mseokq23/etri050-6t-sram/docs/img/02/repo_files.png

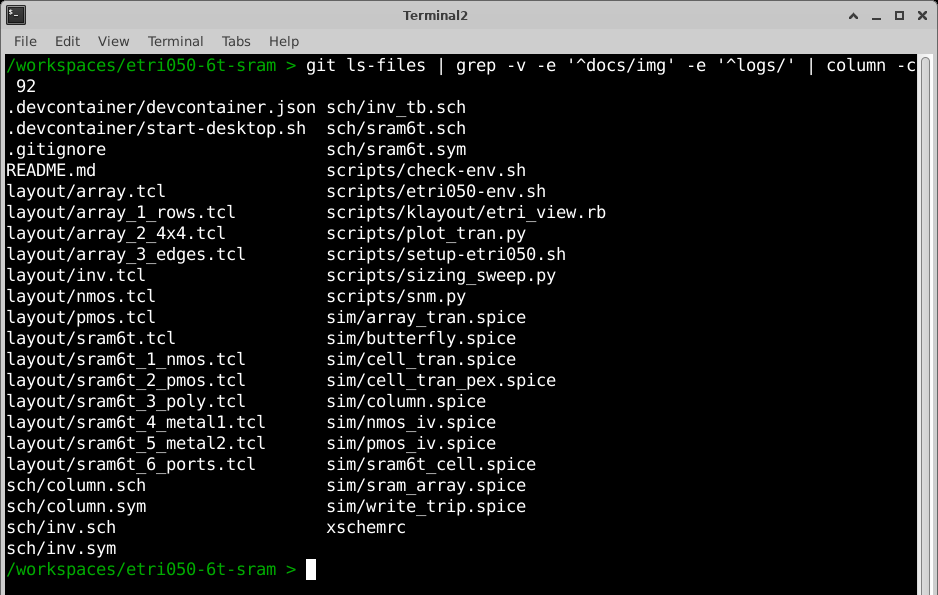
docs/img/02/repo_files.png
