mseokq23/etri050-6t-sram/docs/img/03/desktop.png

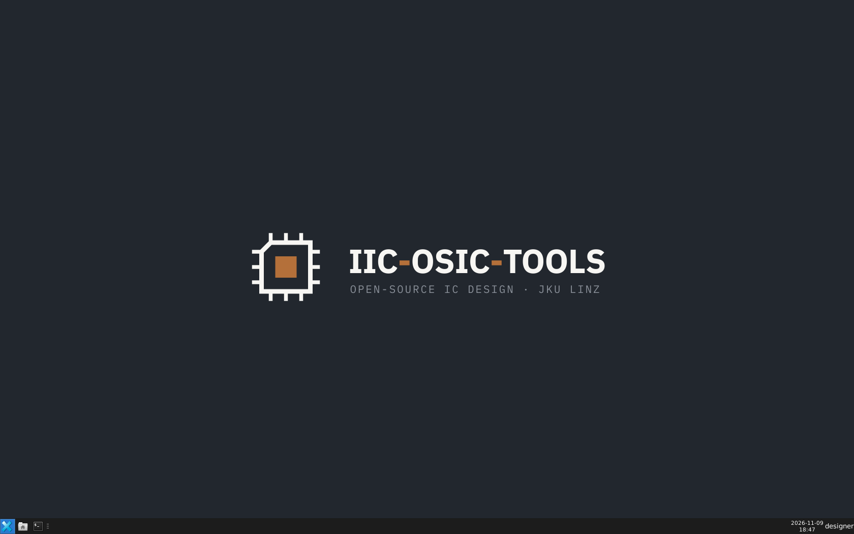
docs/img/03/desktop.png
