mseokq23/etri050-6t-sram/docs/img/03/menu.png

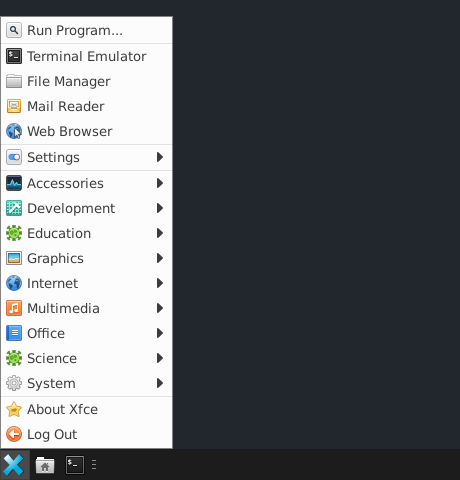
docs/img/03/menu.png
