mseokq23/etri050-6t-sram/docs/img/04/kit_ls.png

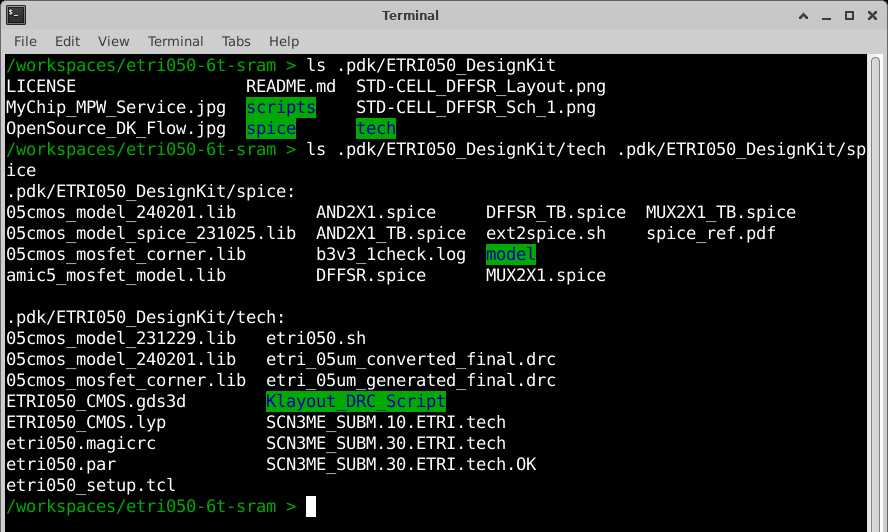
docs/img/04/kit_ls.png
