mseokq23/etri050-6t-sram/docs/img/05/check_env.png

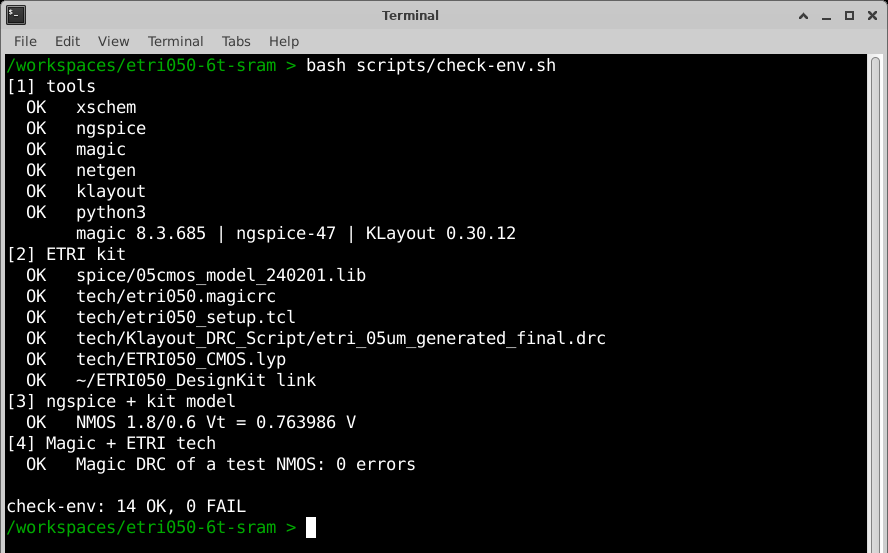
docs/img/05/check_env.png
