mseokq23/etri050-6t-sram/docs/img/05/env_funcs.png

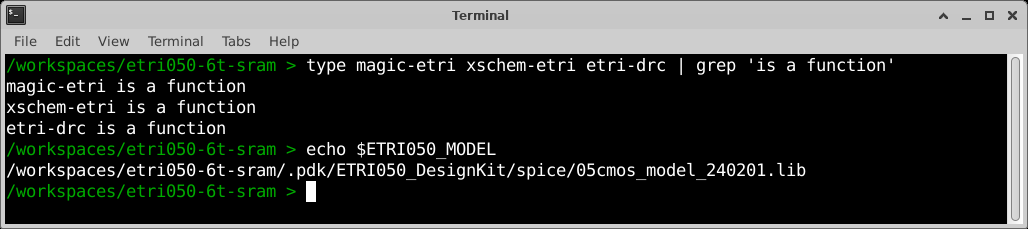
docs/img/05/env_funcs.png
