mseokq23/etri050-6t-sram/docs/img/06/nmos_desktop.png

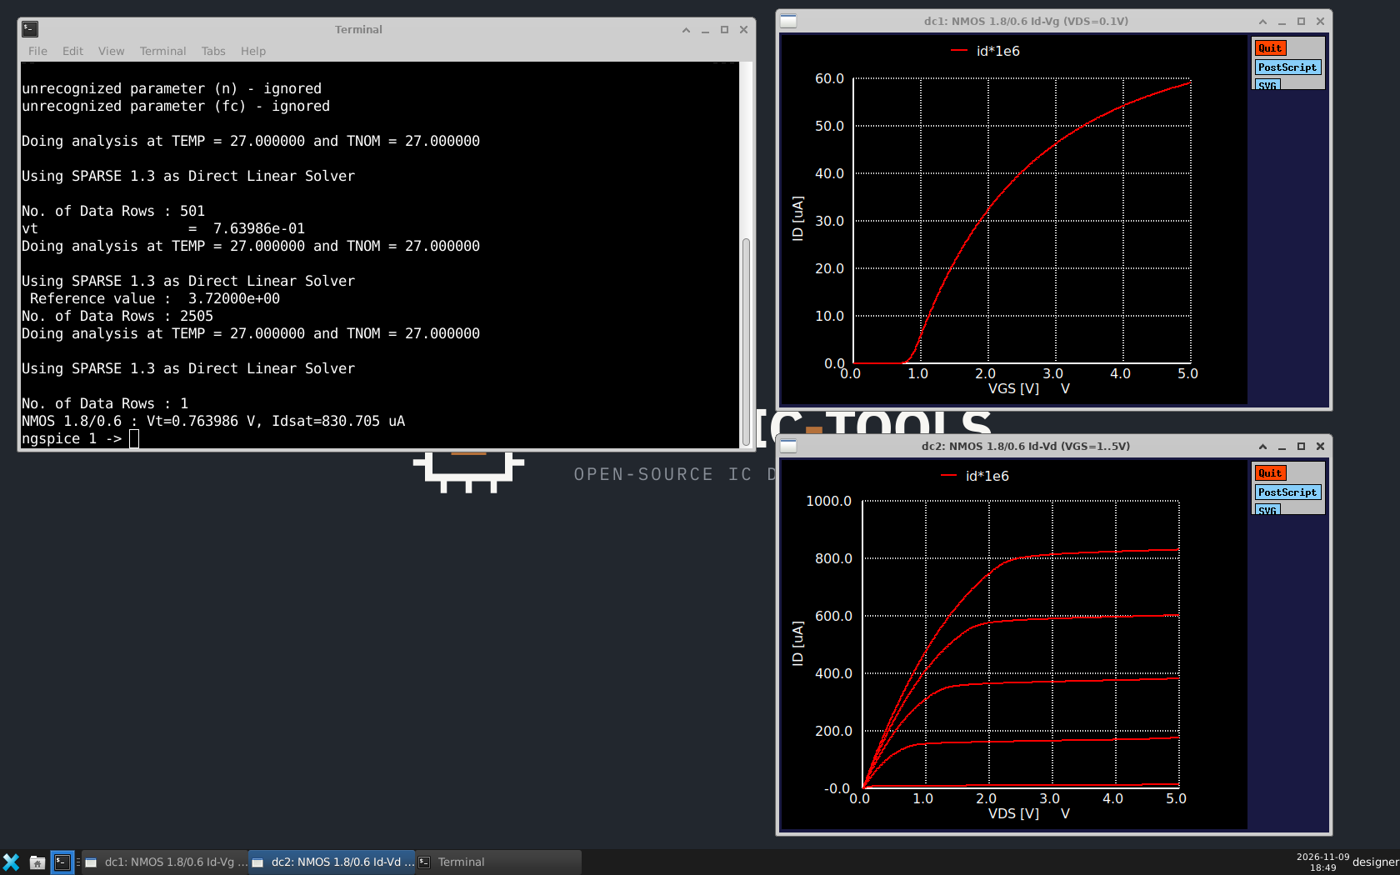
docs/img/06/nmos_desktop.png
