mseokq23/etri050-6t-sram/docs/img/06/nmos_idvg.png

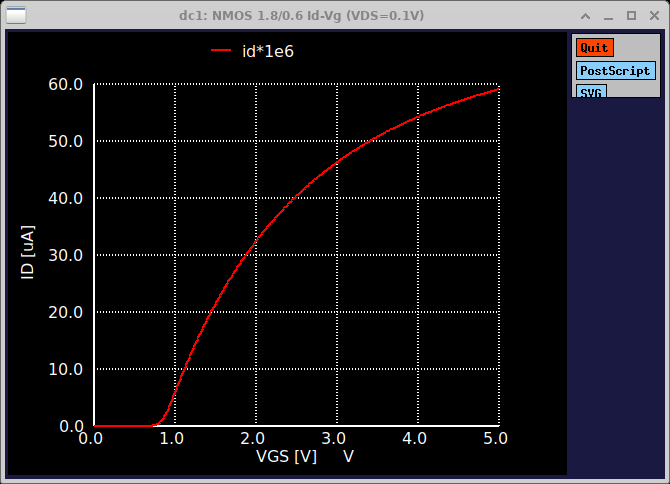
docs/img/06/nmos_idvg.png
