mseokq23/etri050-6t-sram/docs/img/06/nmos_term.png

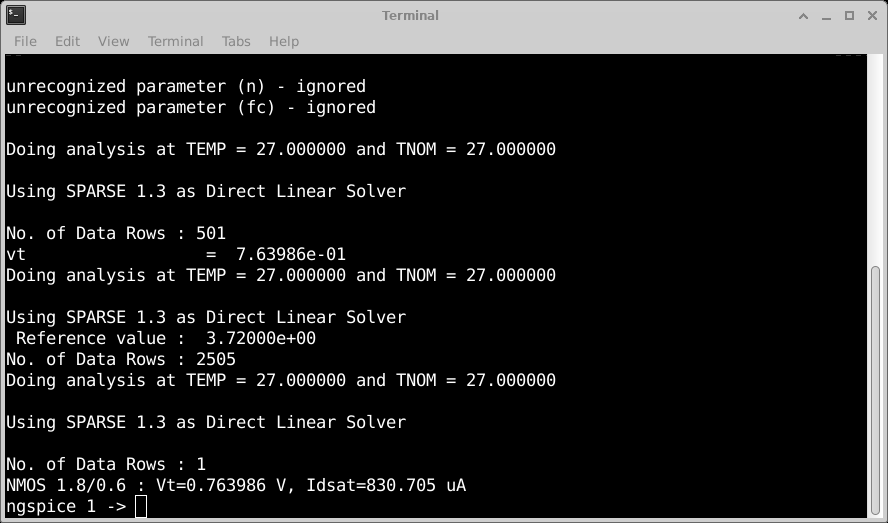
docs/img/06/nmos_term.png
