mseokq23/etri050-6t-sram/docs/img/07/pmos_idvg.png

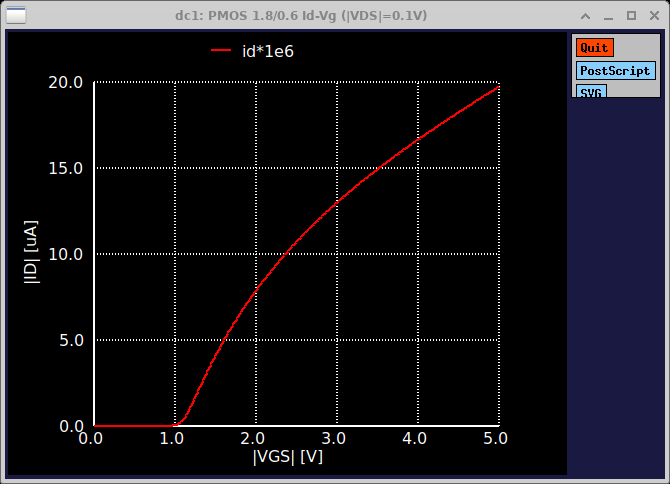
docs/img/07/pmos_idvg.png
