mseokq23/etri050-6t-sram/docs/img/09/insert_dialog_nmos4.png

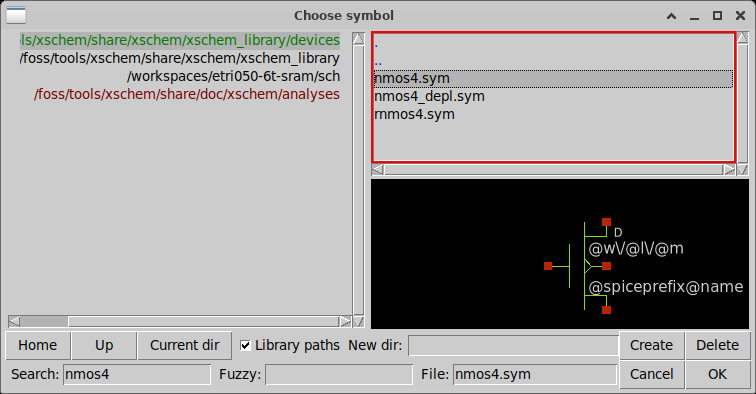
docs/img/09/insert_dialog_nmos4.png
