mseokq23/etri050-6t-sram/docs/img/09/inv_sch.png

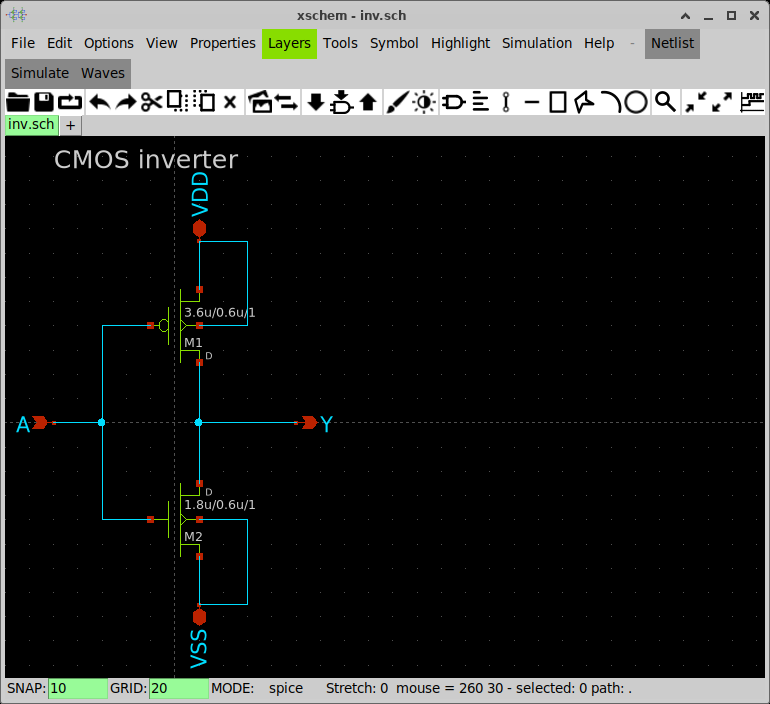
docs/img/09/inv_sch.png
