mseokq23/etri050-6t-sram/docs/img/09/inv_sym.png

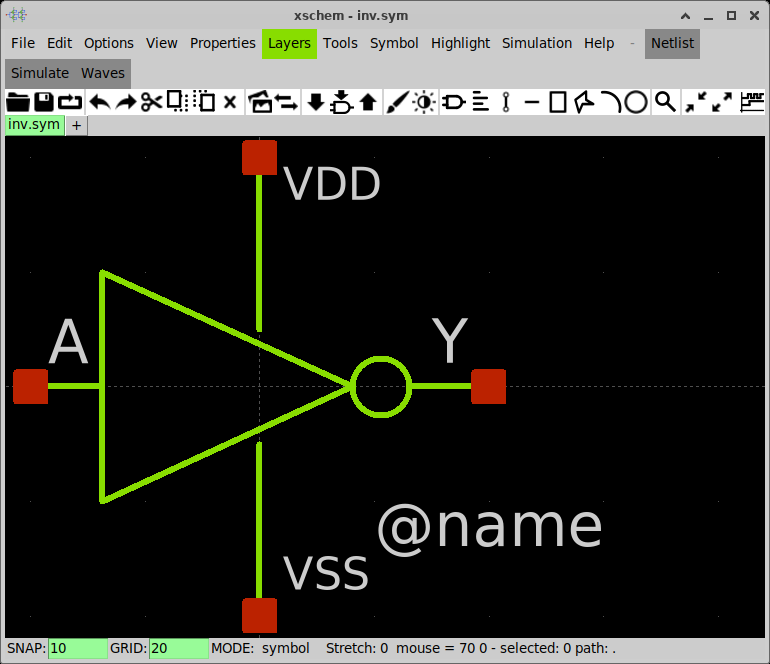
docs/img/09/inv_sym.png
