mseokq23/etri050-6t-sram/docs/img/09/props_desktop.png

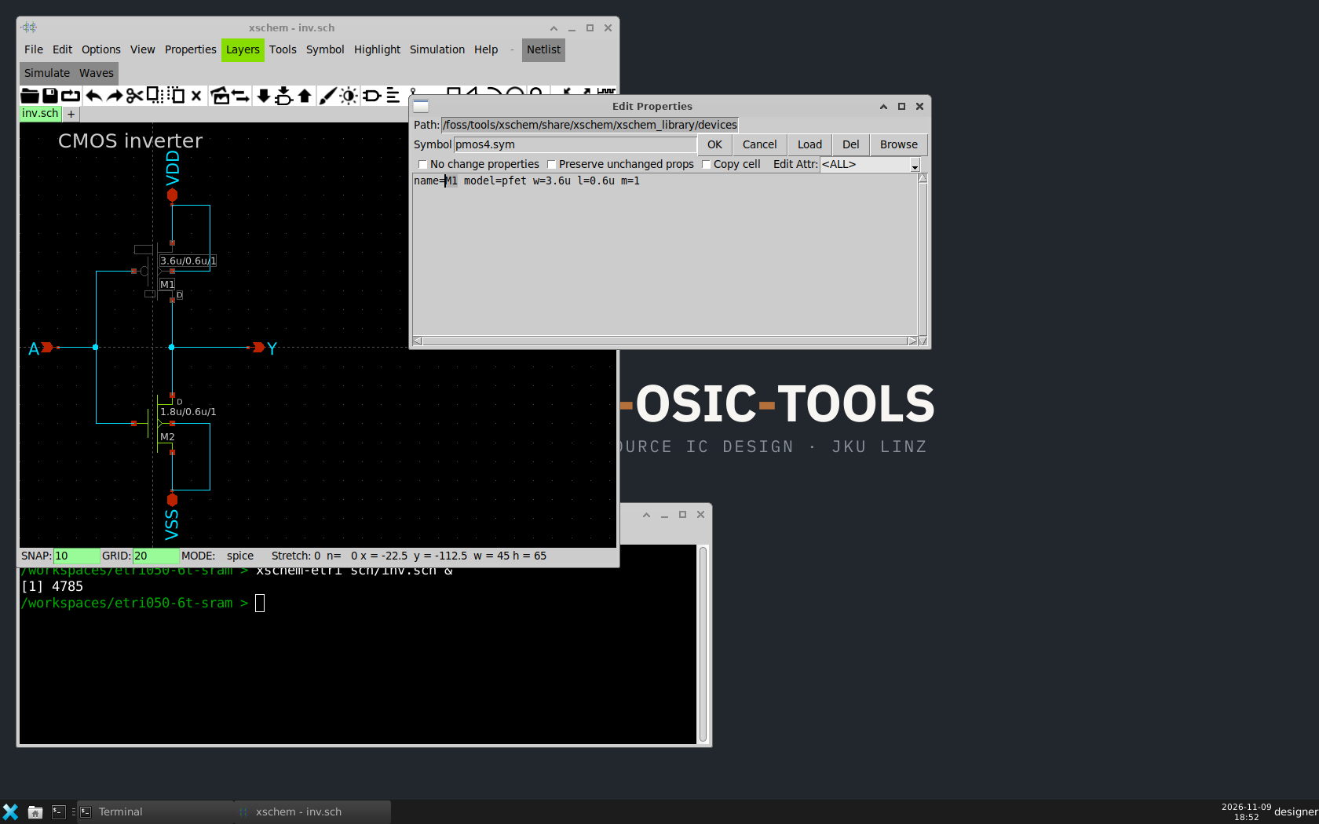
docs/img/09/props_desktop.png
