mseokq23/etri050-6t-sram/docs/img/09/xschem_empty.png

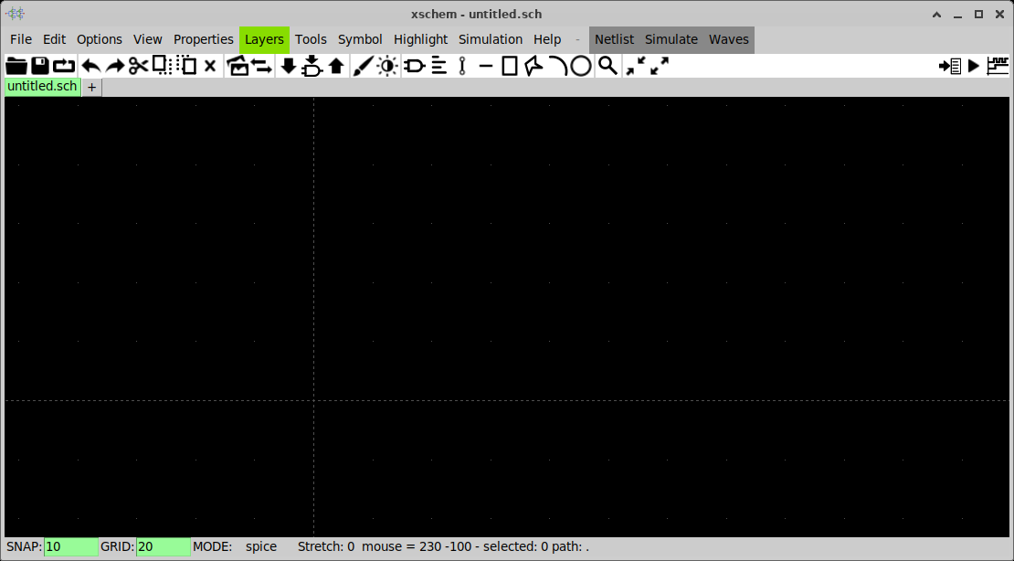
docs/img/09/xschem_empty.png
