mseokq23/etri050-6t-sram/docs/img/09/xschem_empty_desktop.png

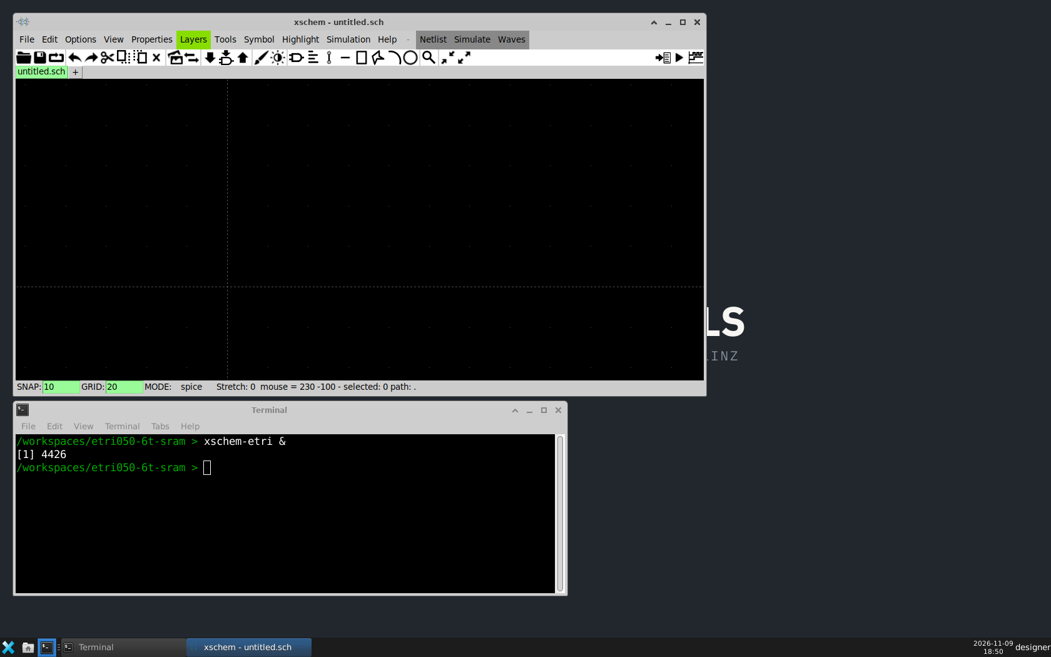
docs/img/09/xschem_empty_desktop.png
