mseokq23/etri050-6t-sram/docs/img/10/inv_tb.png

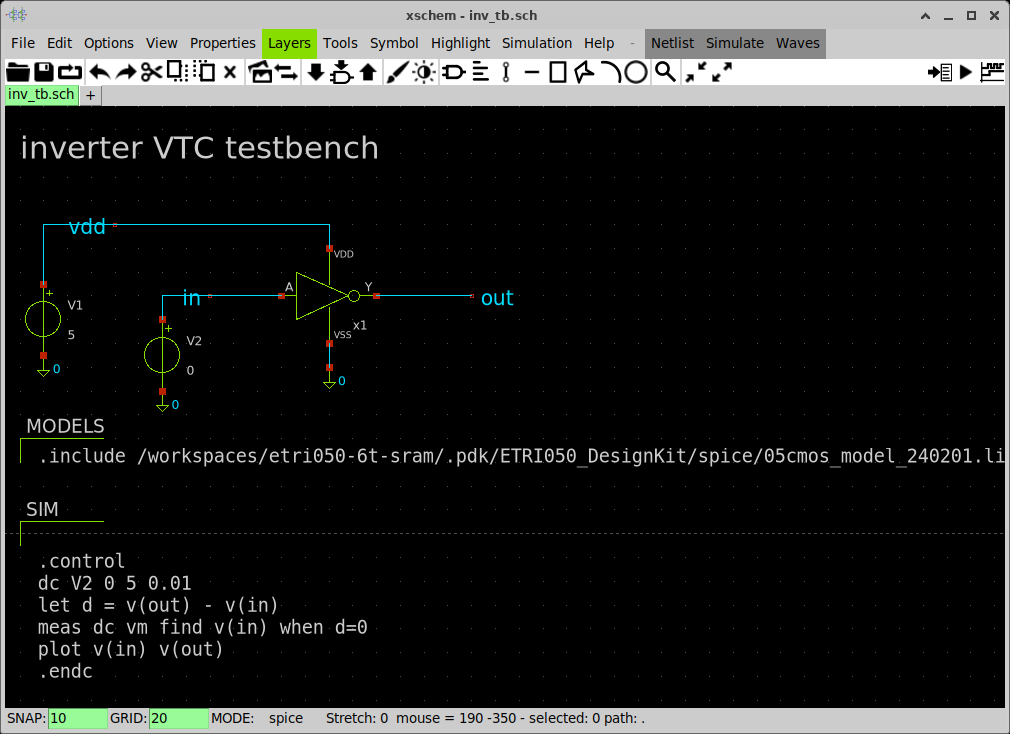
docs/img/10/inv_tb.png
