mseokq23/etri050-6t-sram/docs/img/10/sim_desktop.png

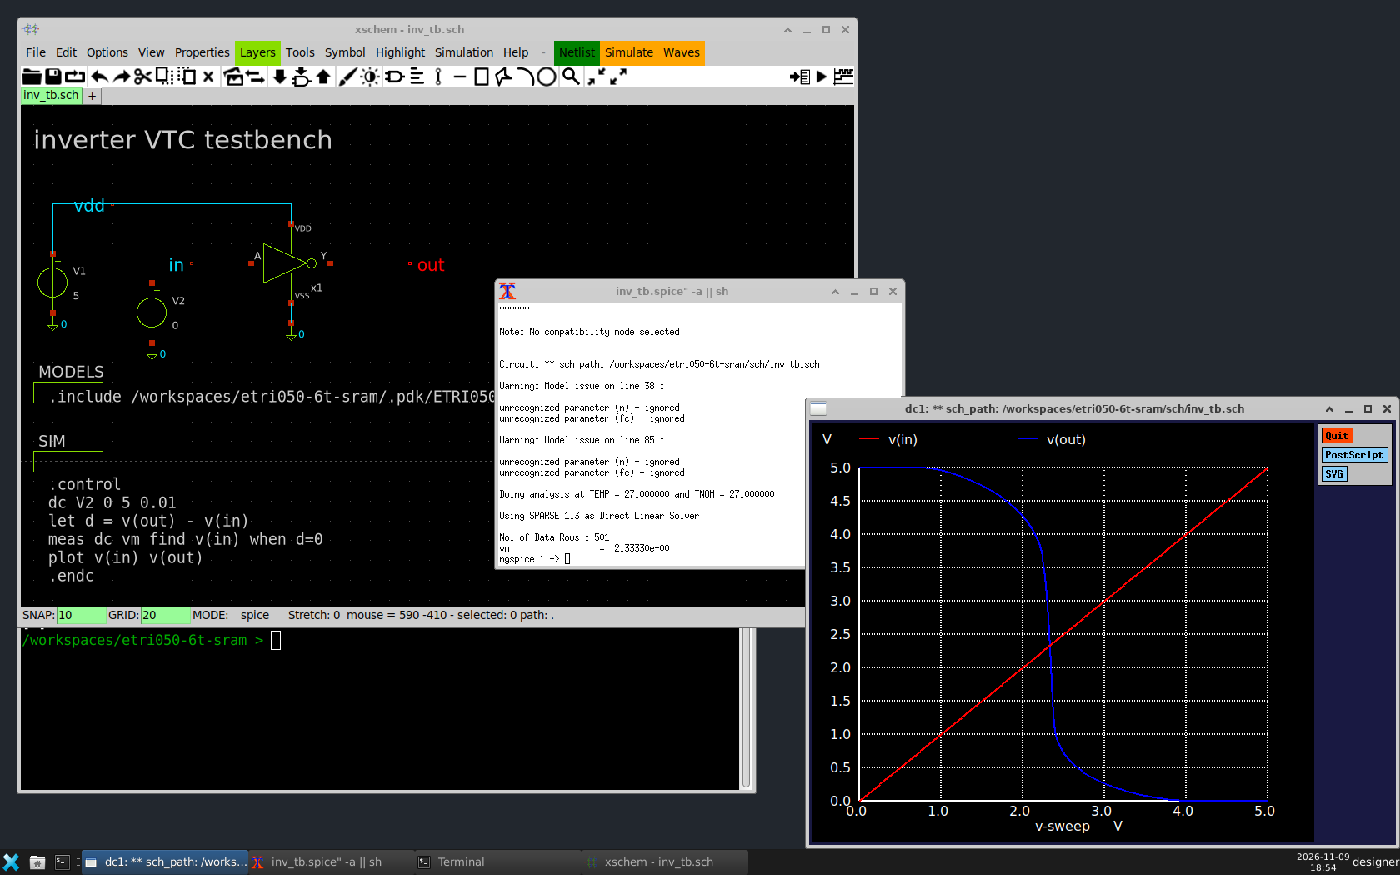
docs/img/10/sim_desktop.png
