mseokq23/etri050-6t-sram/docs/img/10/sim_xterm.png

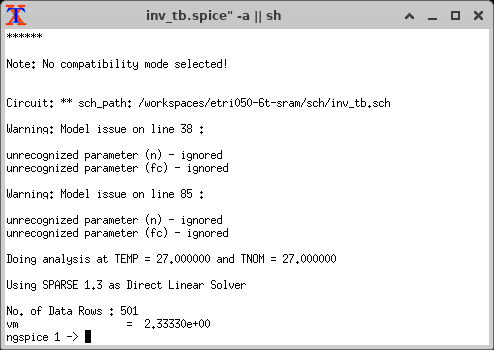
docs/img/10/sim_xterm.png
