mseokq23/etri050-6t-sram/docs/img/10/vtc_plot.png

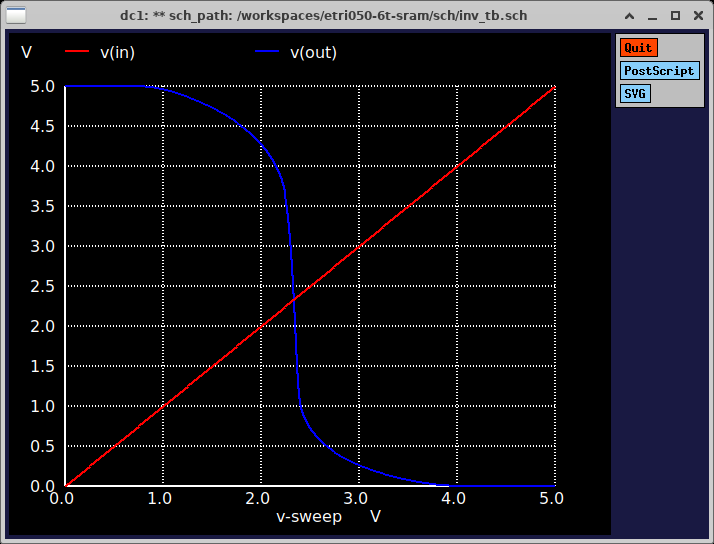
docs/img/10/vtc_plot.png
