mseokq23/etri050-6t-sram/docs/img/11/lvs_netlist.png

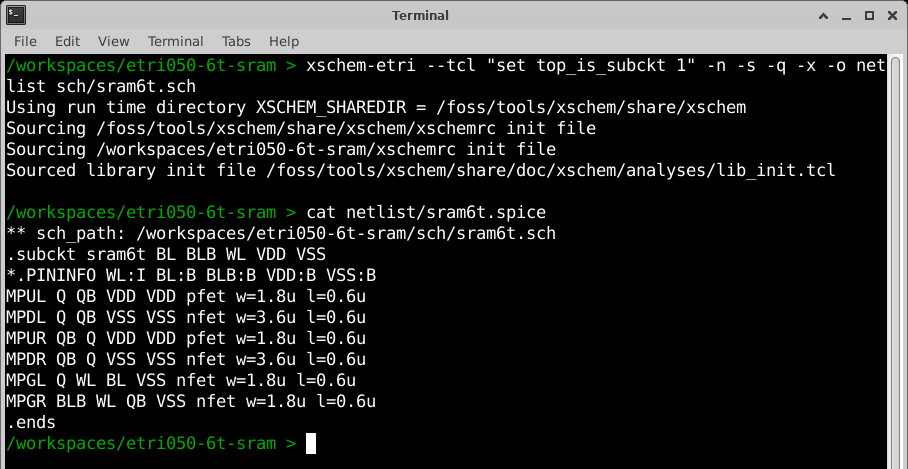
docs/img/11/lvs_netlist.png
