mseokq23/etri050-6t-sram/docs/img/11/sram6t_sch.png

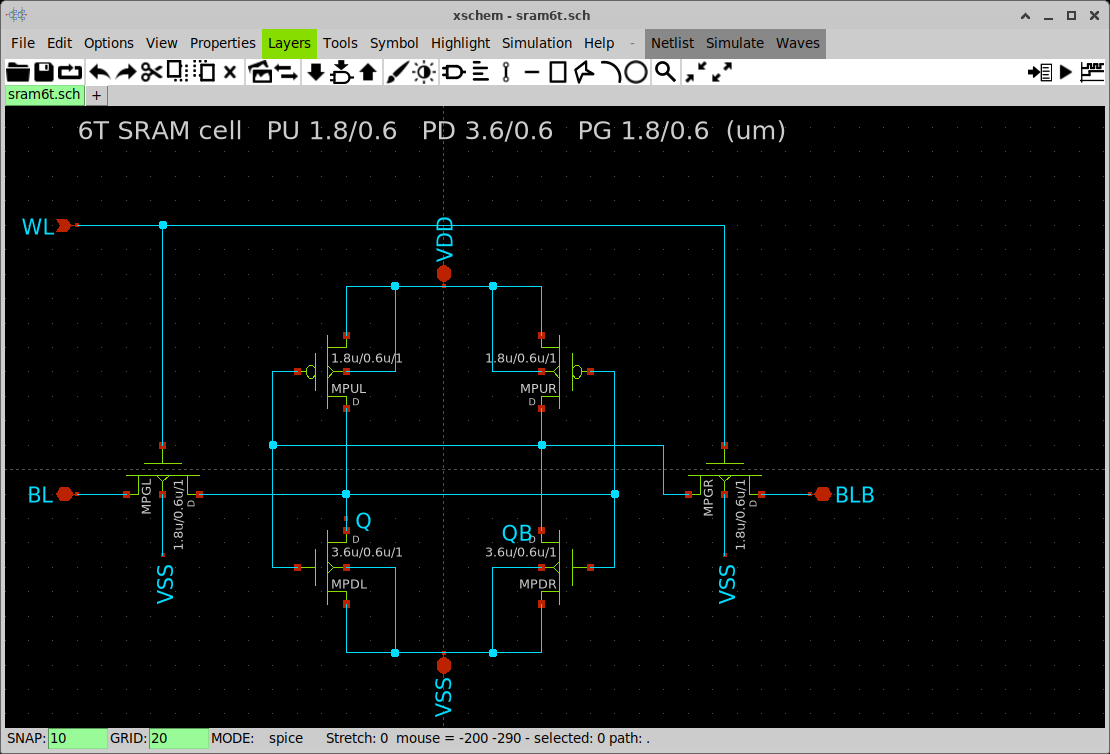
docs/img/11/sram6t_sch.png
