mseokq23/etri050-6t-sram/docs/img/11/sram6t_sym.png

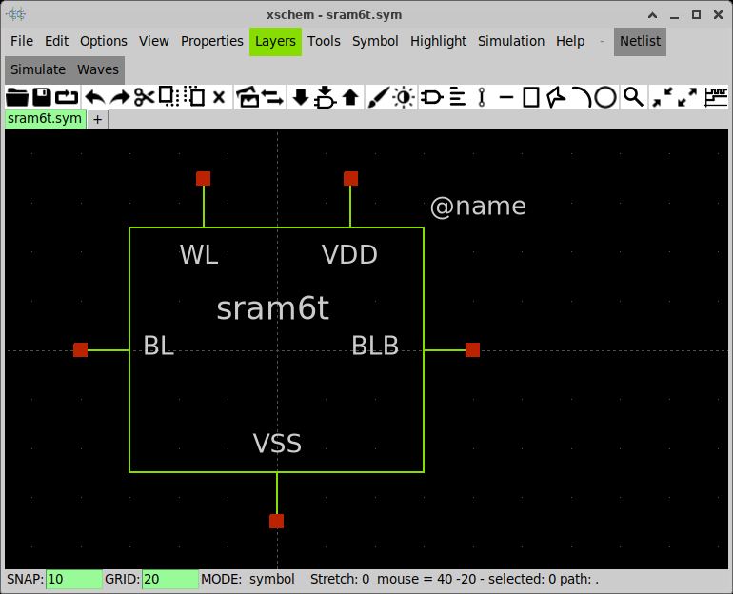
docs/img/11/sram6t_sym.png
