mseokq23/etri050-6t-sram/docs/img/12/butterfly_hold.png

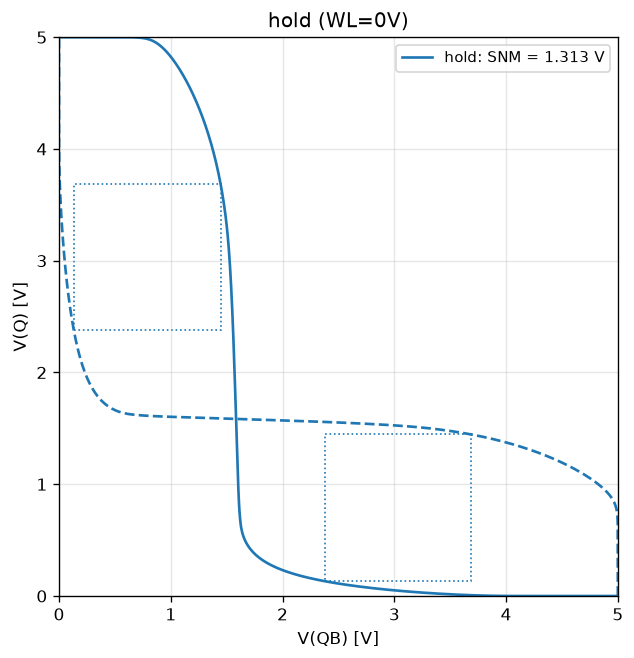
docs/img/12/butterfly_hold.png
