mseokq23/etri050-6t-sram/docs/img/12/snm_hold_term.png

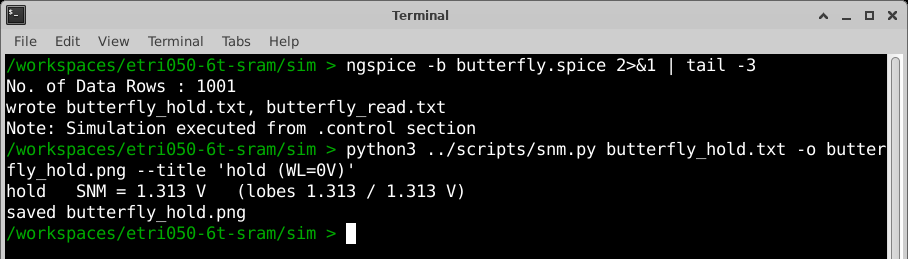
docs/img/12/snm_hold_term.png
