mseokq23/etri050-6t-sram/docs/img/13/butterfly_hold_read.png

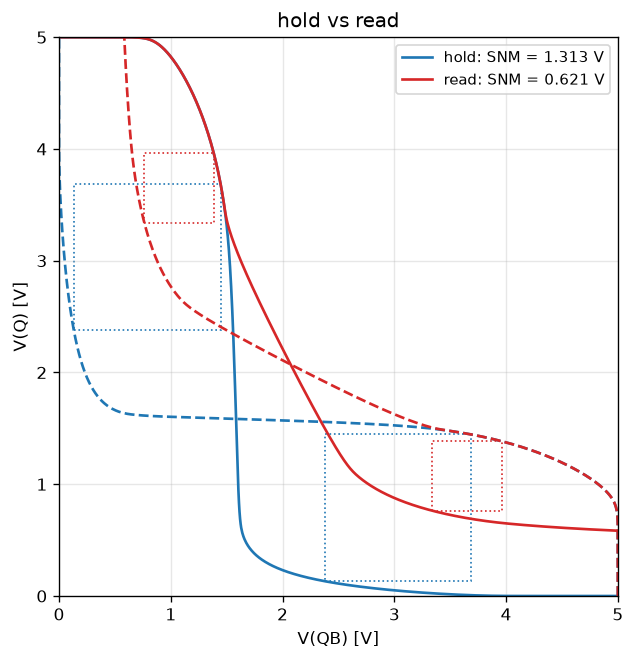
docs/img/13/butterfly_hold_read.png
