mseokq23/etri050-6t-sram/docs/img/14/write_trip_desktop.png

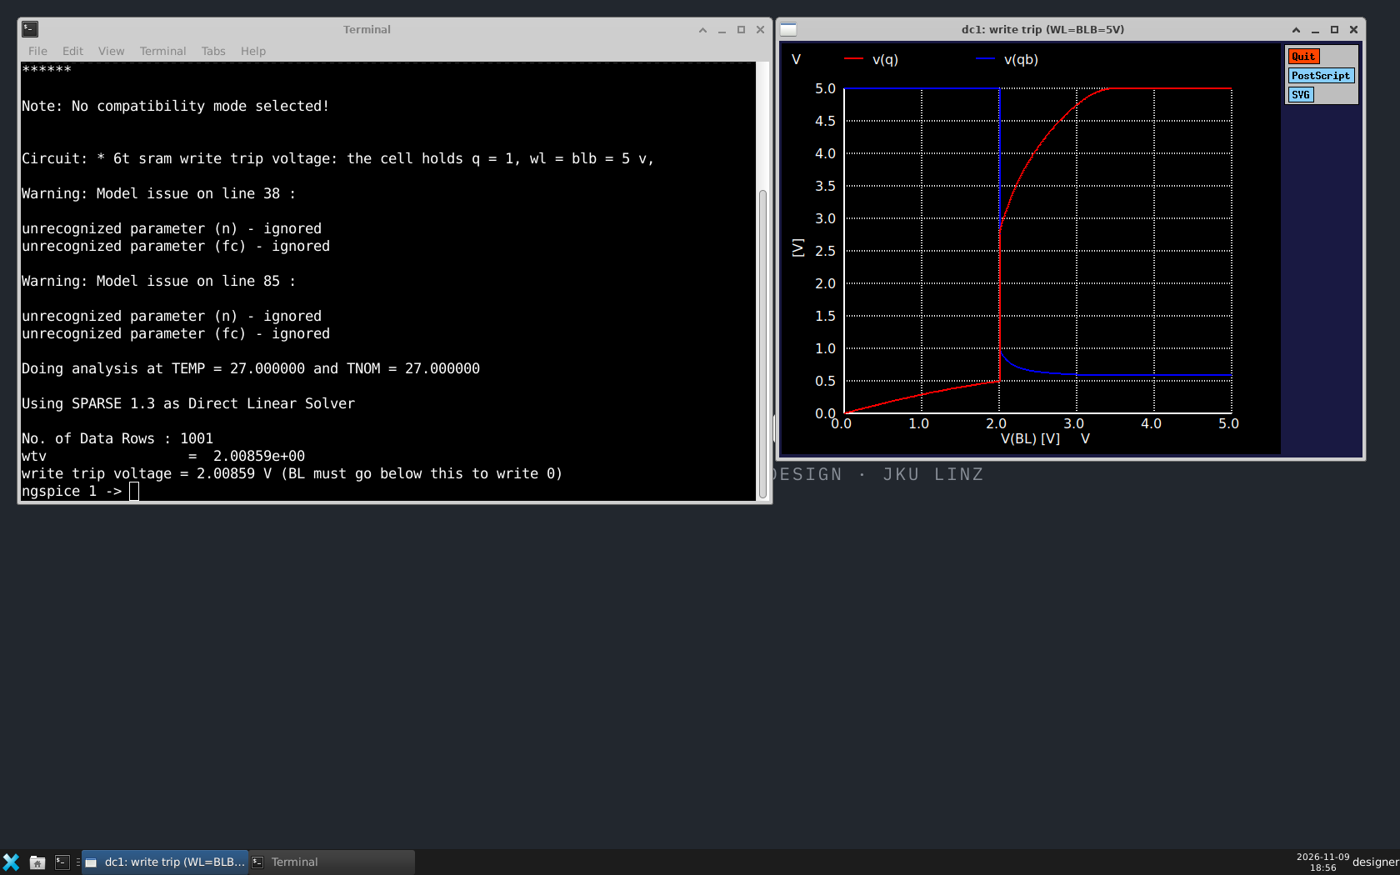
docs/img/14/write_trip_desktop.png
