mseokq23/etri050-6t-sram/docs/img/15/sizing_sweep.png

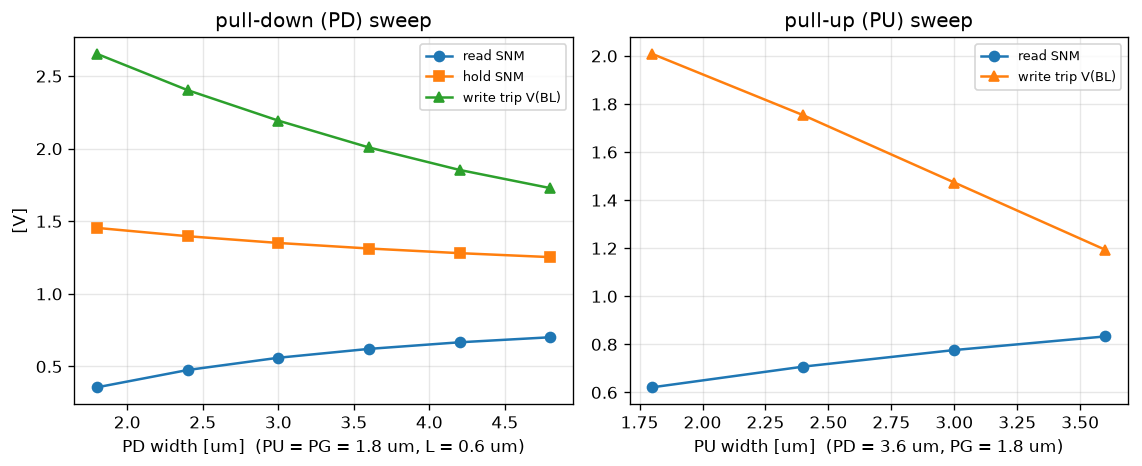
docs/img/15/sizing_sweep.png
