mseokq23/etri050-6t-sram/docs/img/15/sizing_term.png

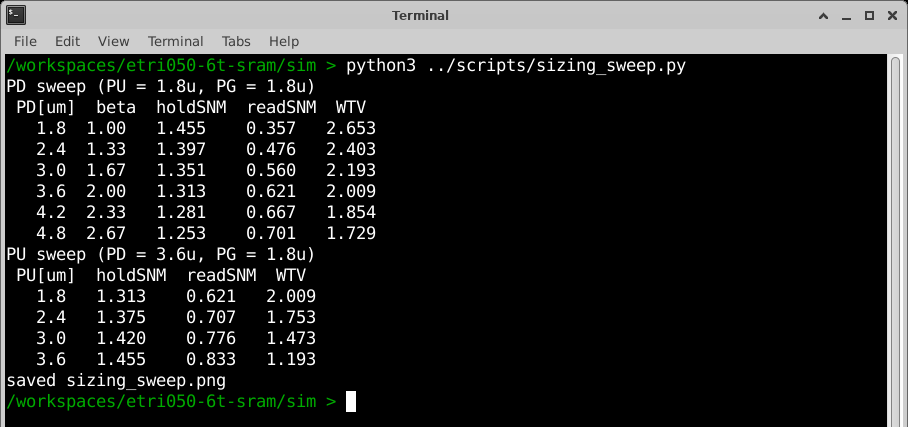
docs/img/15/sizing_term.png
