mseokq23/etri050-6t-sram/docs/img/16/column_sch.png

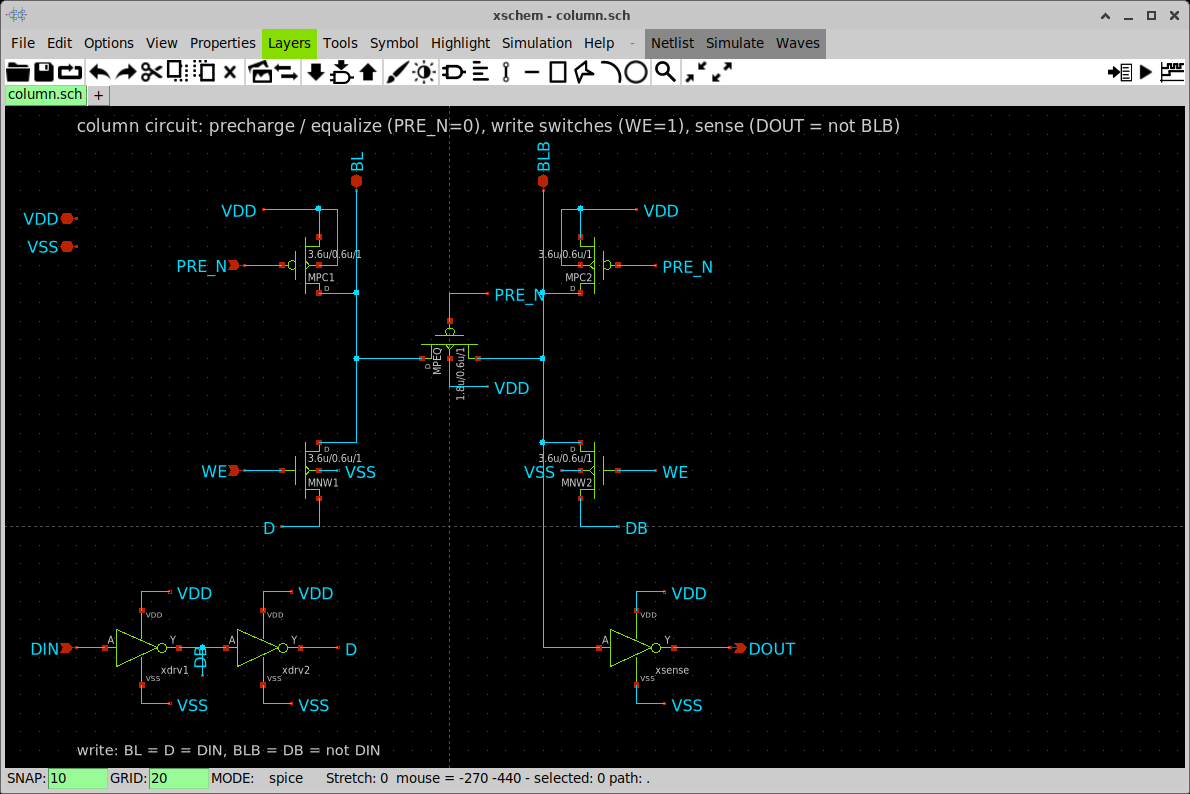
docs/img/16/column_sch.png
