mseokq23/etri050-6t-sram/docs/img/17/cell_tran_desktop.png

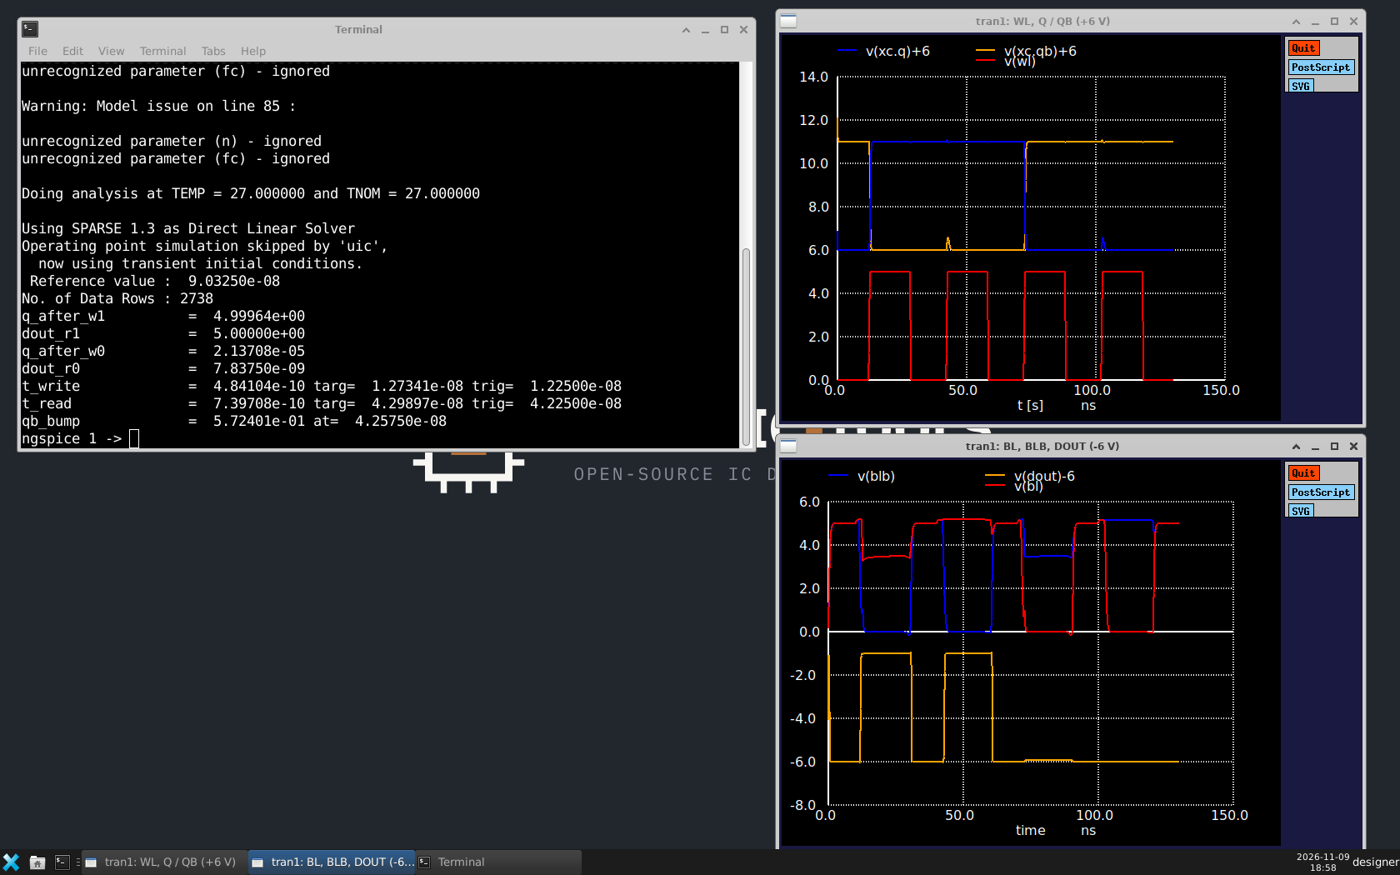
docs/img/17/cell_tran_desktop.png
