mseokq23/etri050-6t-sram/docs/img/17/cell_tran_term.png

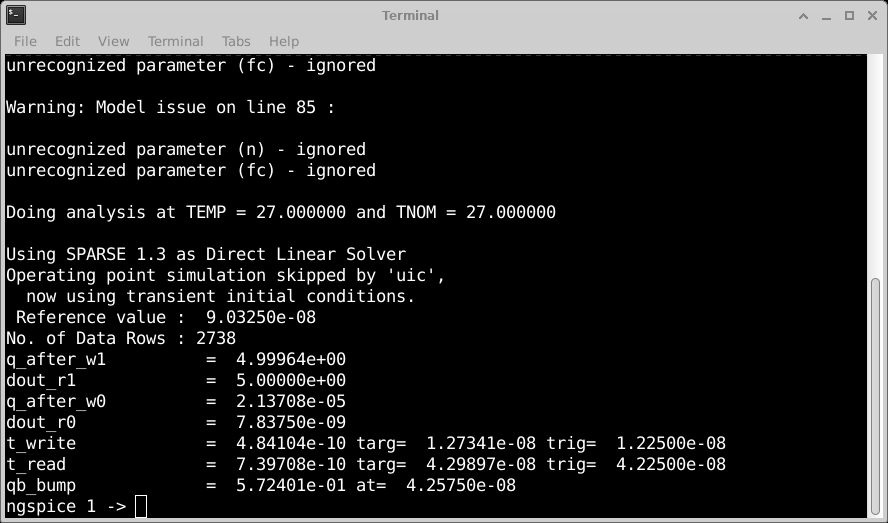
docs/img/17/cell_tran_term.png
