mseokq23/etri050-6t-sram/docs/img/18/magic_console_paint.png

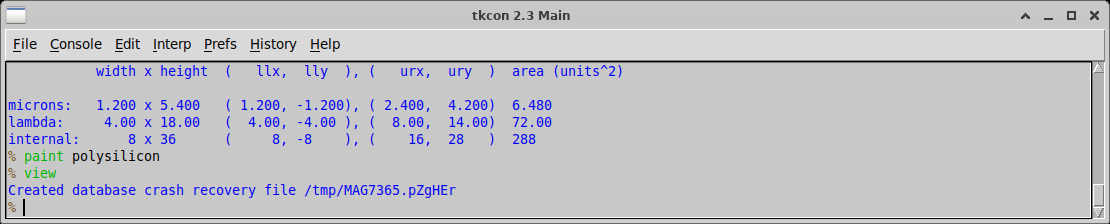
docs/img/18/magic_console_paint.png
