mseokq23/etri050-6t-sram/docs/img/18/magic_grid.png

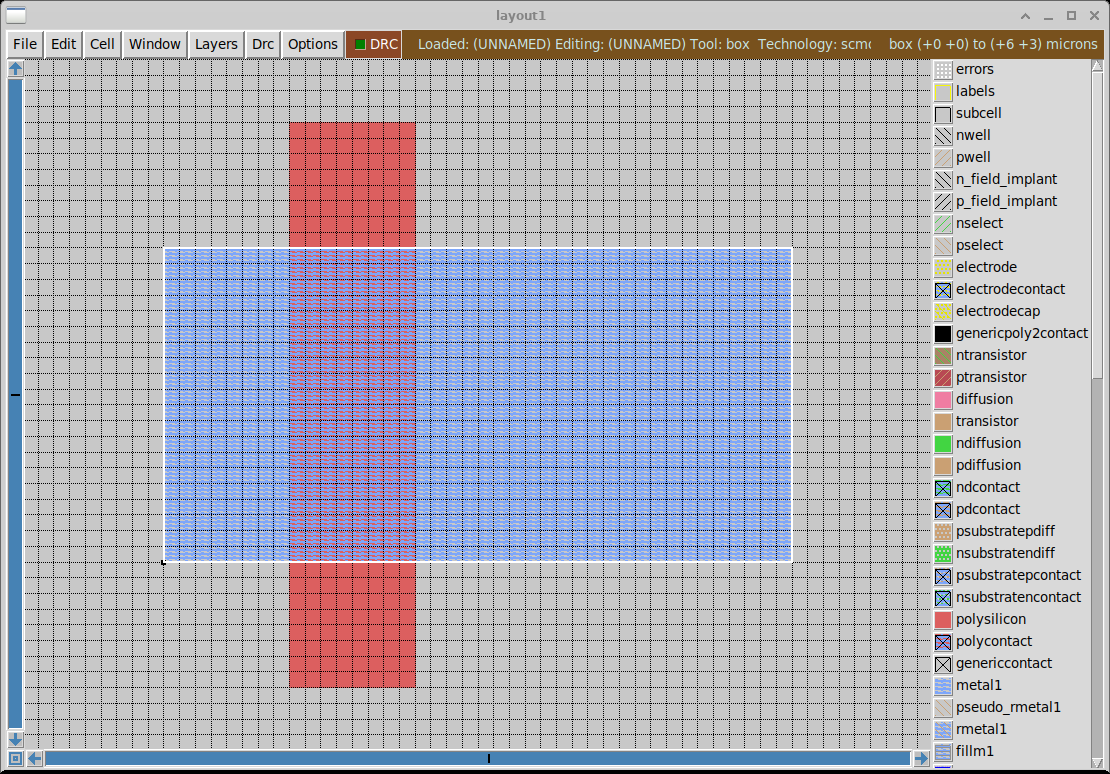
docs/img/18/magic_grid.png
