mseokq23/etri050-6t-sram/docs/img/18/magic_start.png

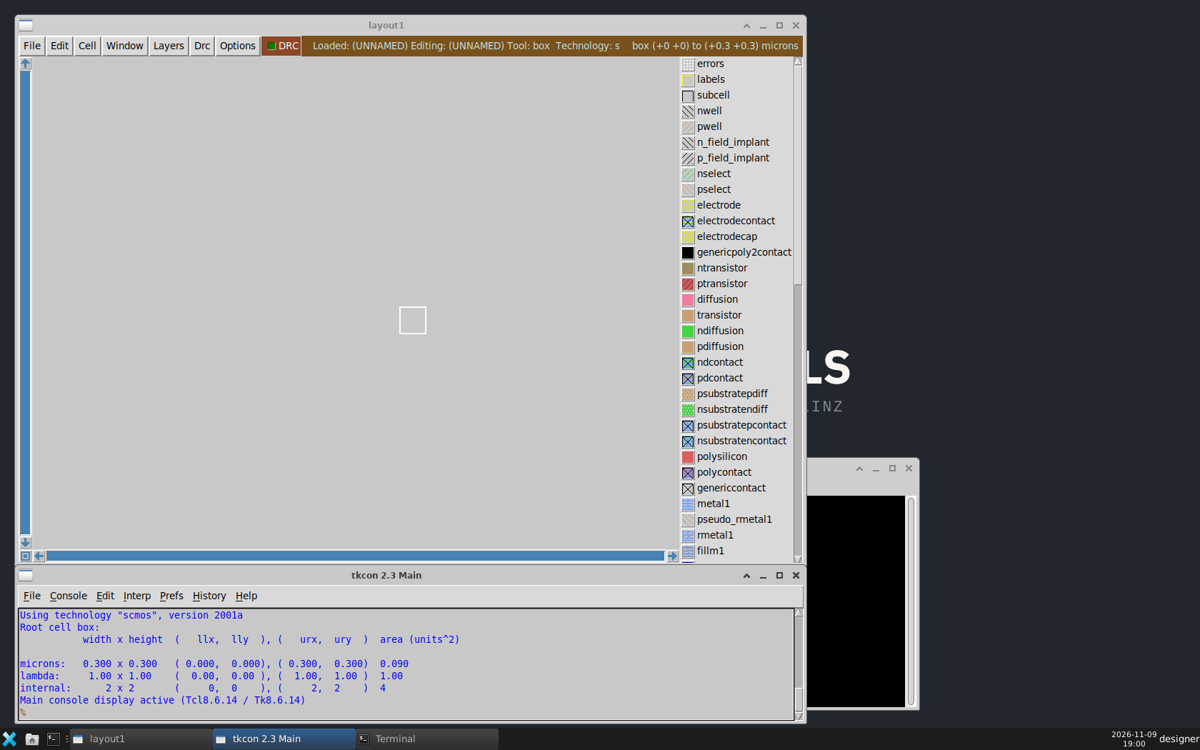
docs/img/18/magic_start.png
