mseokq23/etri050-6t-sram/docs/img/18/magic_start_console.png

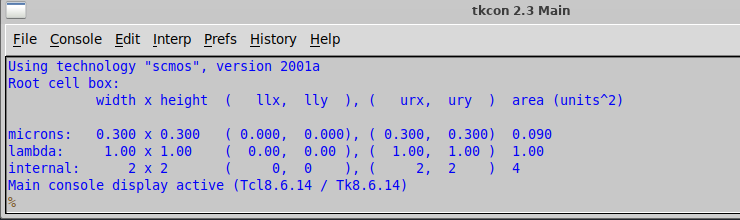
docs/img/18/magic_start_console.png
