mseokq23/etri050-6t-sram/docs/img/19/nmos_drc.png

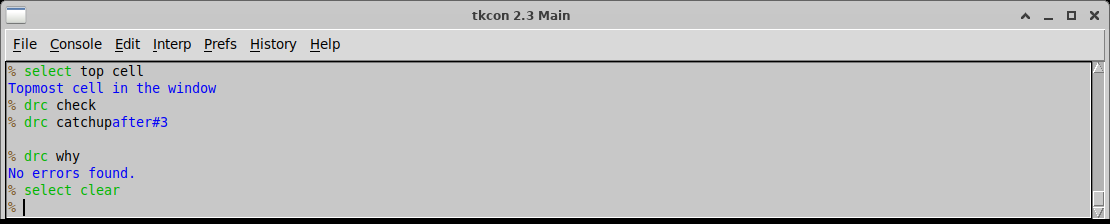
docs/img/19/nmos_drc.png
