mseokq23/etri050-6t-sram/docs/img/19/nmos_layout.png

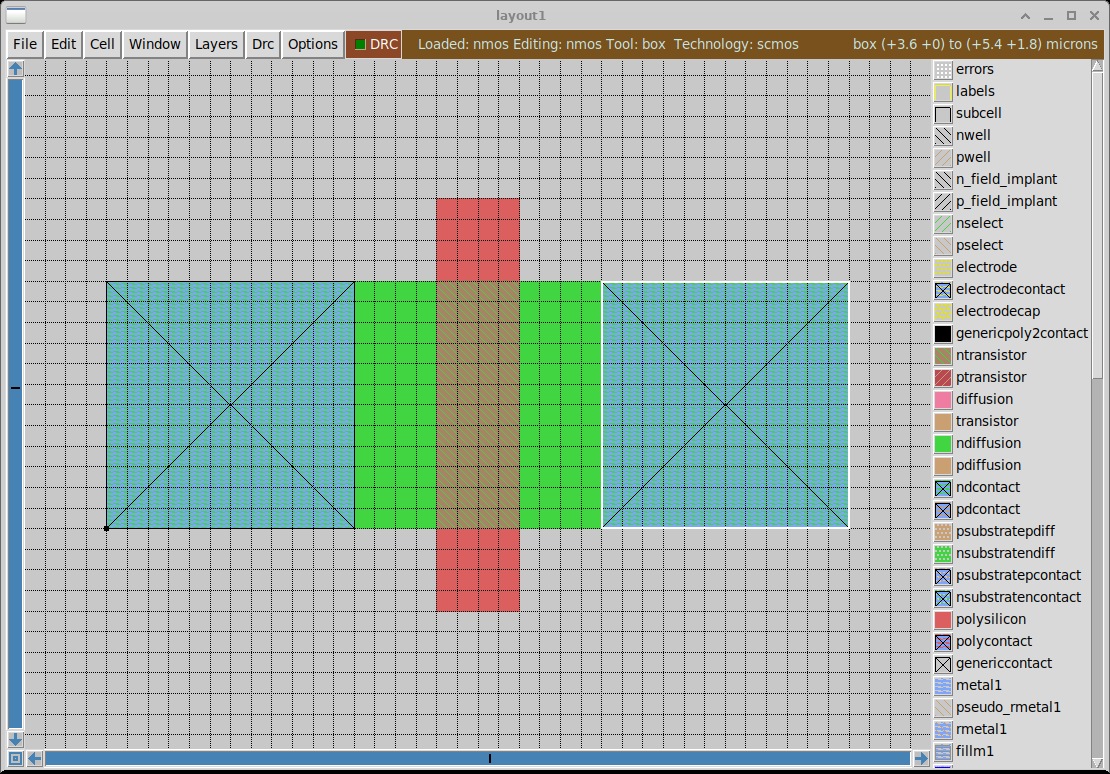
docs/img/19/nmos_layout.png
