mseokq23/etri050-6t-sram/docs/img/19/nmos_what.png

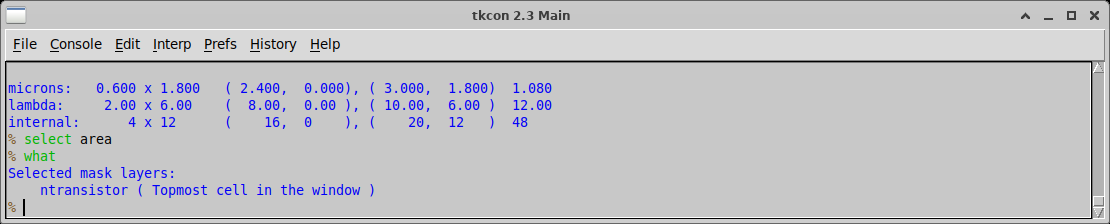
docs/img/19/nmos_what.png
