mseokq23/etri050-6t-sram/docs/img/20/pmos_drc_error.png

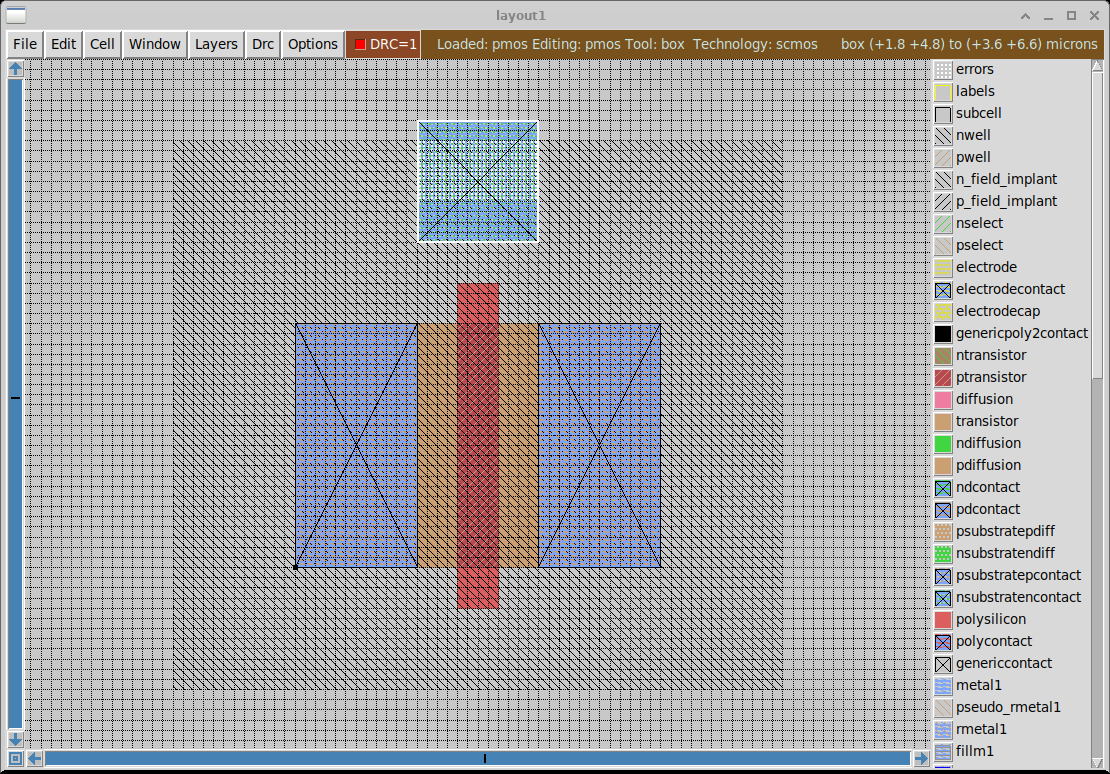
docs/img/20/pmos_drc_error.png
