mseokq23/etri050-6t-sram/docs/img/21/inv_lvs_term.png

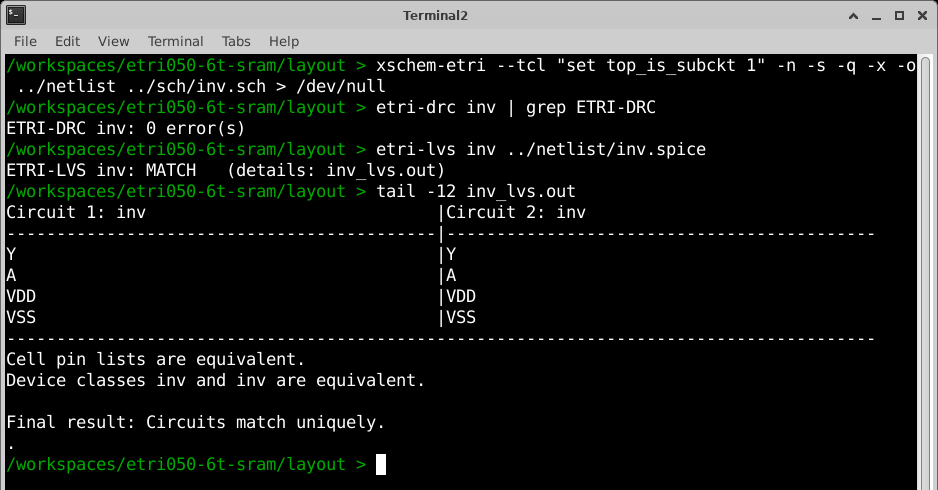
docs/img/21/inv_lvs_term.png
