mseokq23/etri050-6t-sram/docs/img/22/sram6t_floorplan.png

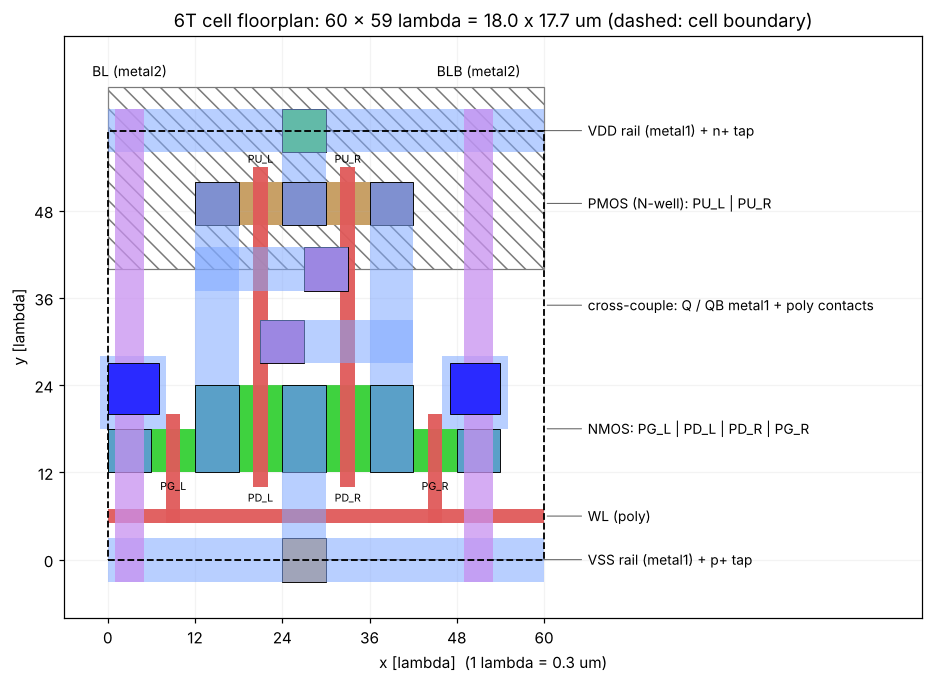
docs/img/22/sram6t_floorplan.png
