mseokq23/etri050-6t-sram/docs/img/27/sram6t_lvs_term.png

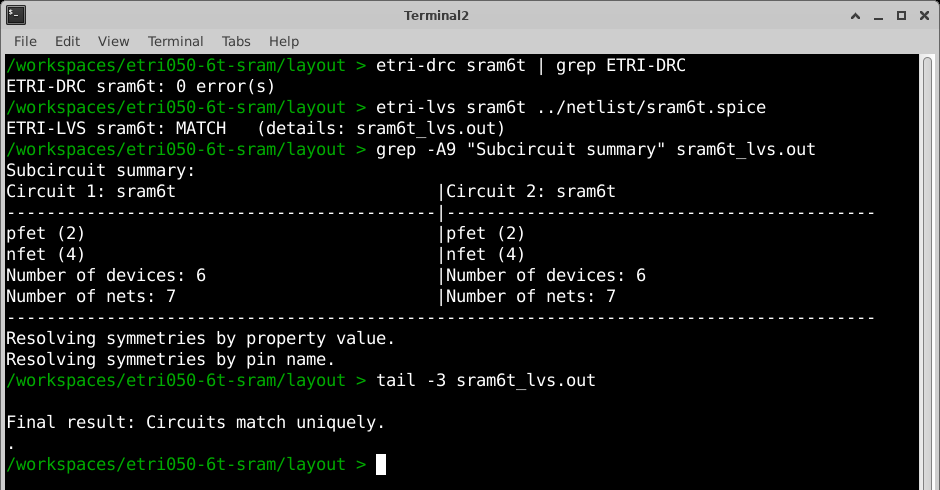
docs/img/27/sram6t_lvs_term.png
