mseokq23/etri050-6t-sram/docs/img/28/cell_tran_pex_term.png

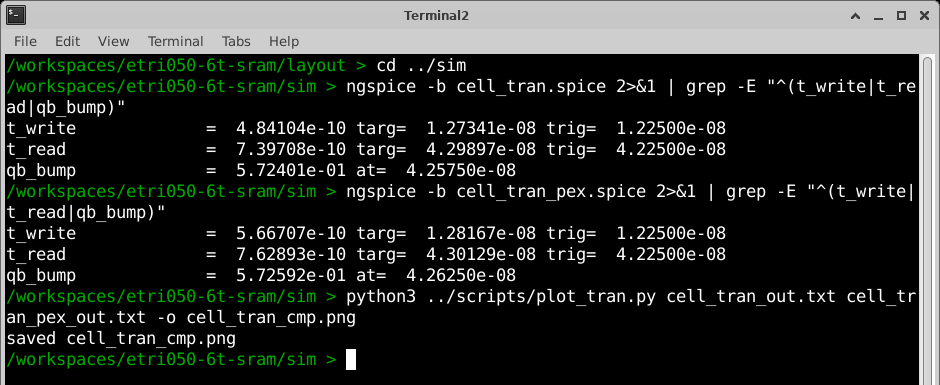
docs/img/28/cell_tran_pex_term.png
