mseokq23/etri050-6t-sram/docs/img/28/sram6t_pex_term.png

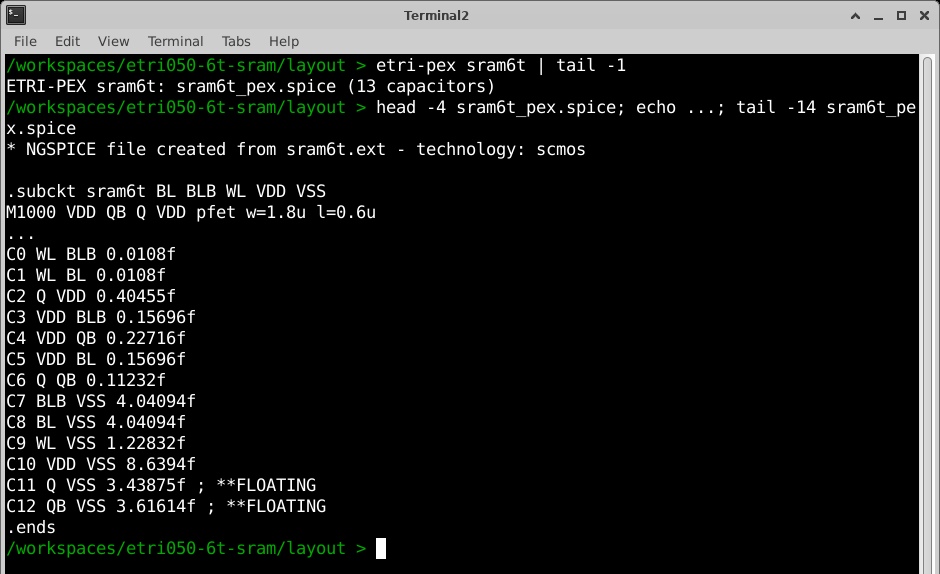
docs/img/28/sram6t_pex_term.png
