mseokq23/etri050-6t-sram/docs/img/29/array_4x4_boxes.png

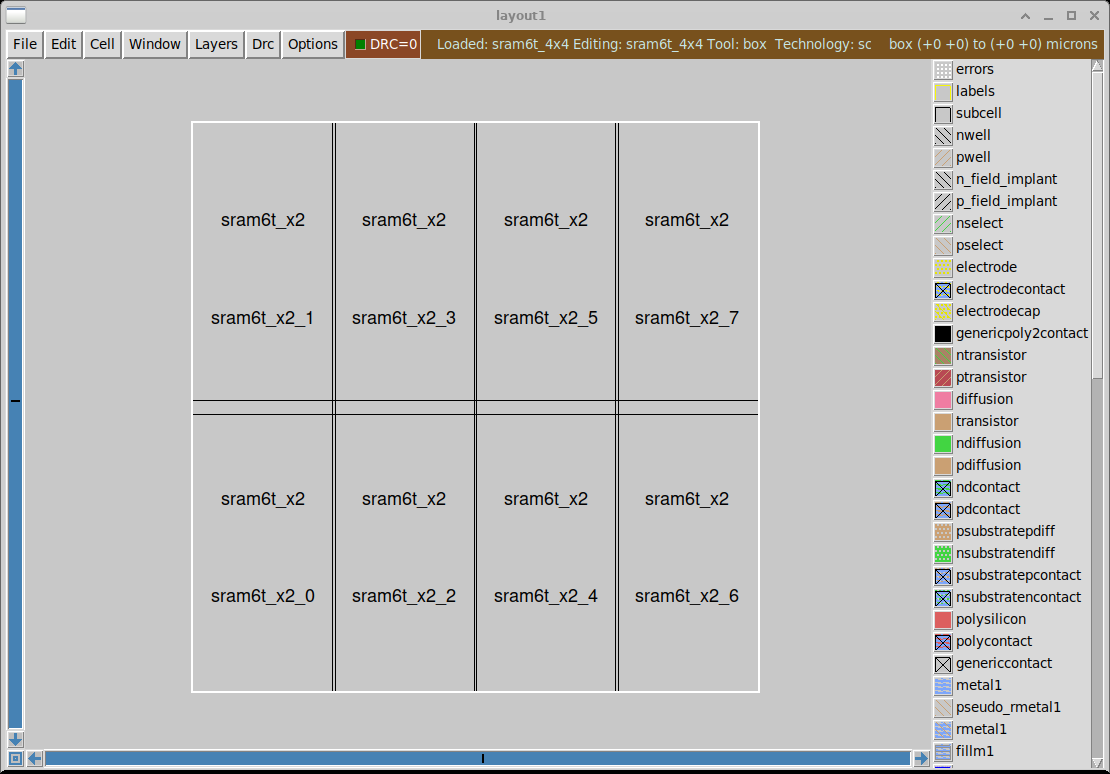
docs/img/29/array_4x4_boxes.png
