mseokq23/etri050-6t-sram/docs/img/29/array_rows.png

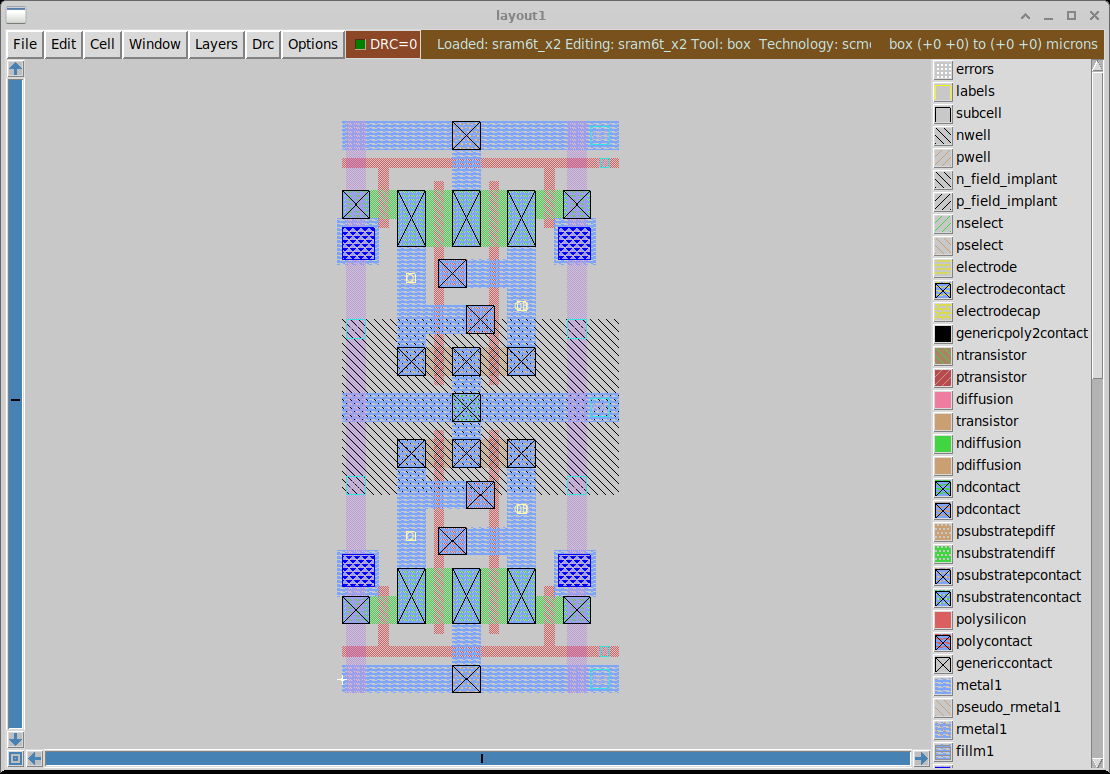
docs/img/29/array_rows.png
