mseokq23/etri050-6t-sram/docs/img/30/sram_array_lvs_term.png

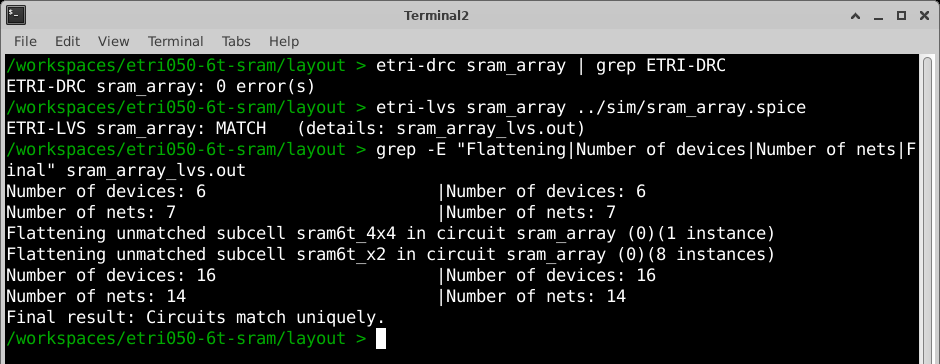
docs/img/30/sram_array_lvs_term.png
