mseokq23/etri050-6t-sram/docs/img/30/sram_array_power_bus.png

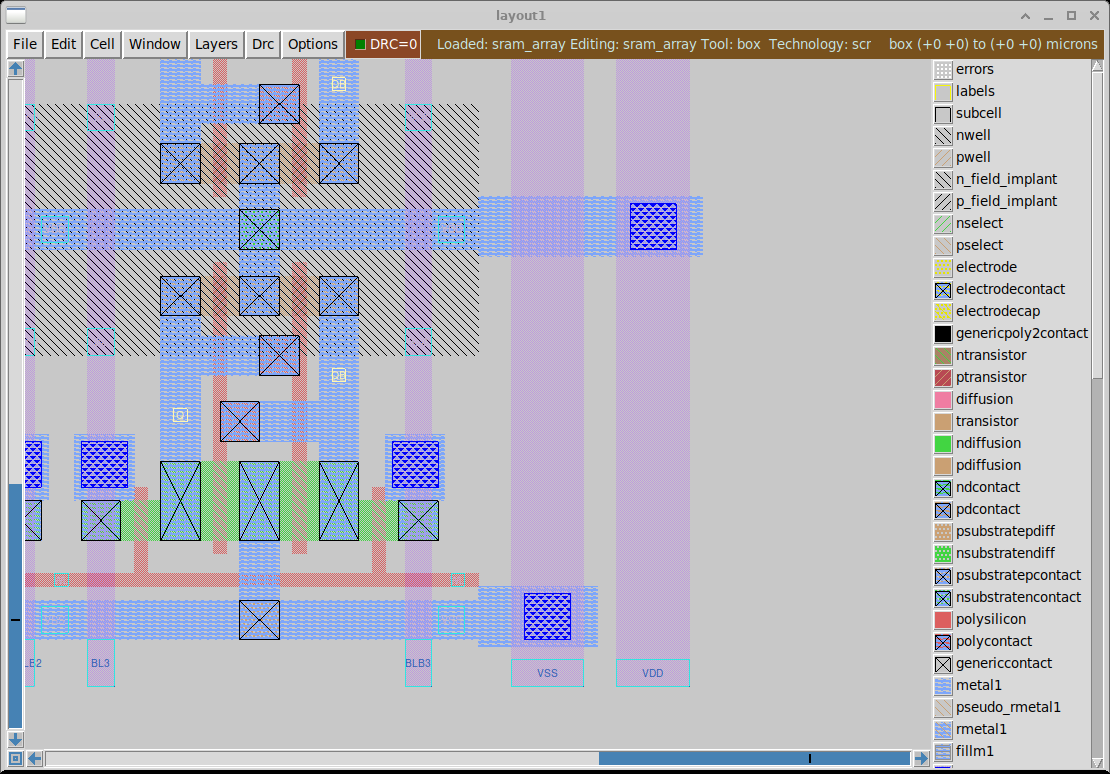
docs/img/30/sram_array_power_bus.png
