mseokq23/etri050-6t-sram/docs/img/30/sram_array_wl_pins.png

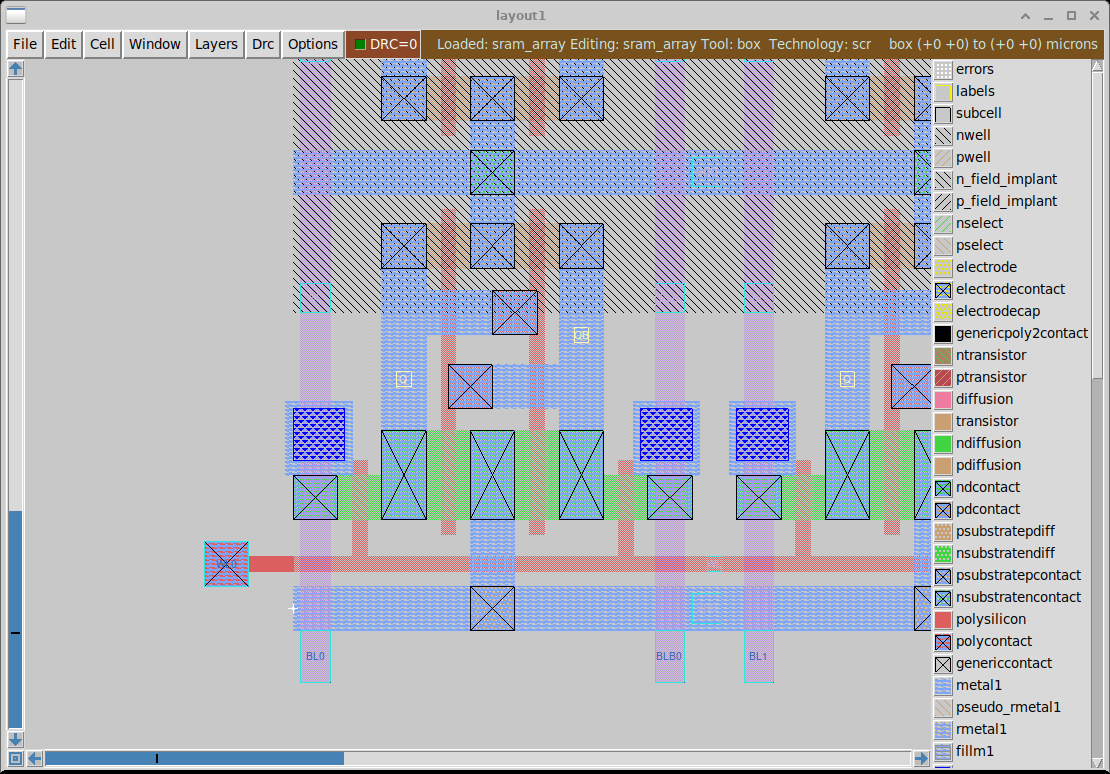
docs/img/30/sram_array_wl_pins.png
