mseokq23/etri050-6t-sram/docs/img/31/array_dout.png

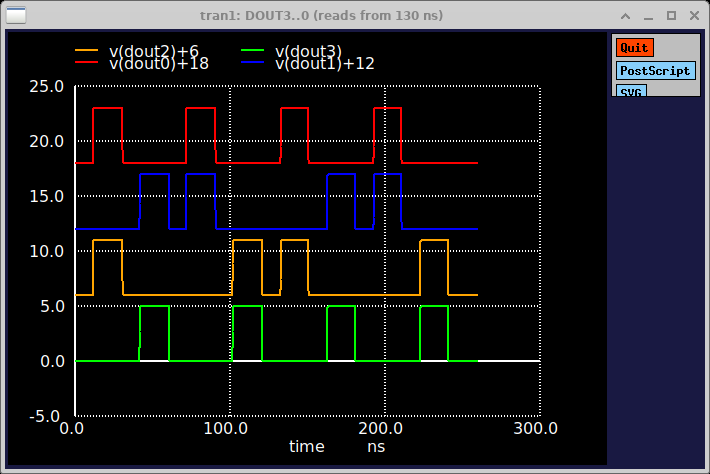
docs/img/31/array_dout.png
