mseokq23/etri050-6t-sram/docs/img/31/array_tran_term.png

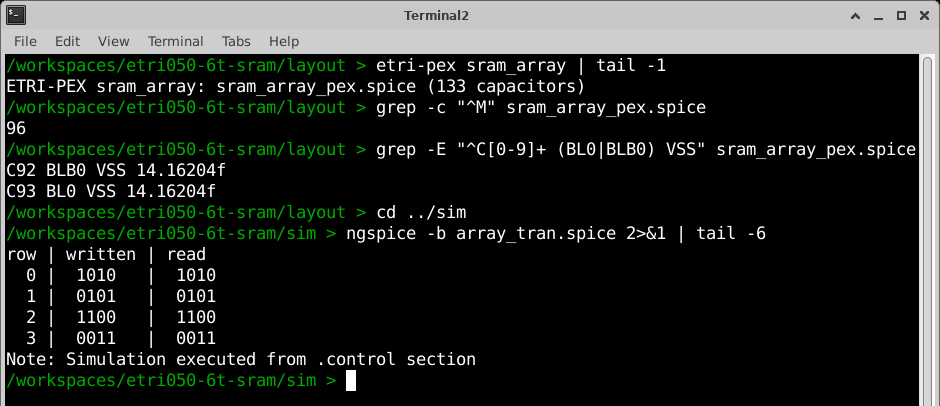
docs/img/31/array_tran_term.png
