mseokq23/etri050-6t-sram/docs/img/31/array_wl.png

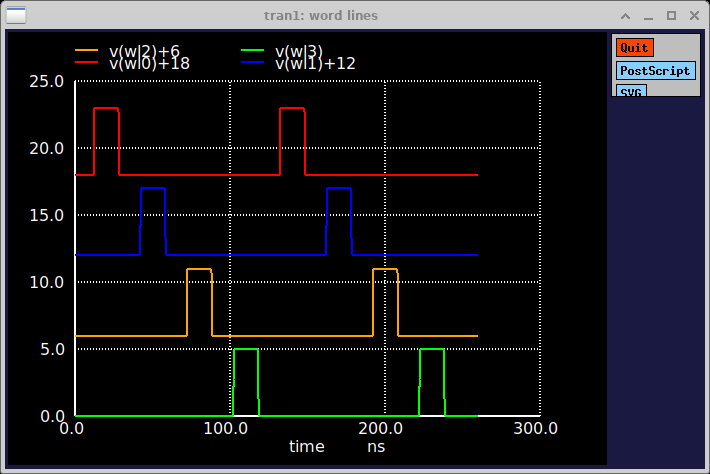
docs/img/31/array_wl.png
