mseokq23/etri050-6t-sram/docs/img/32/gds_term.png

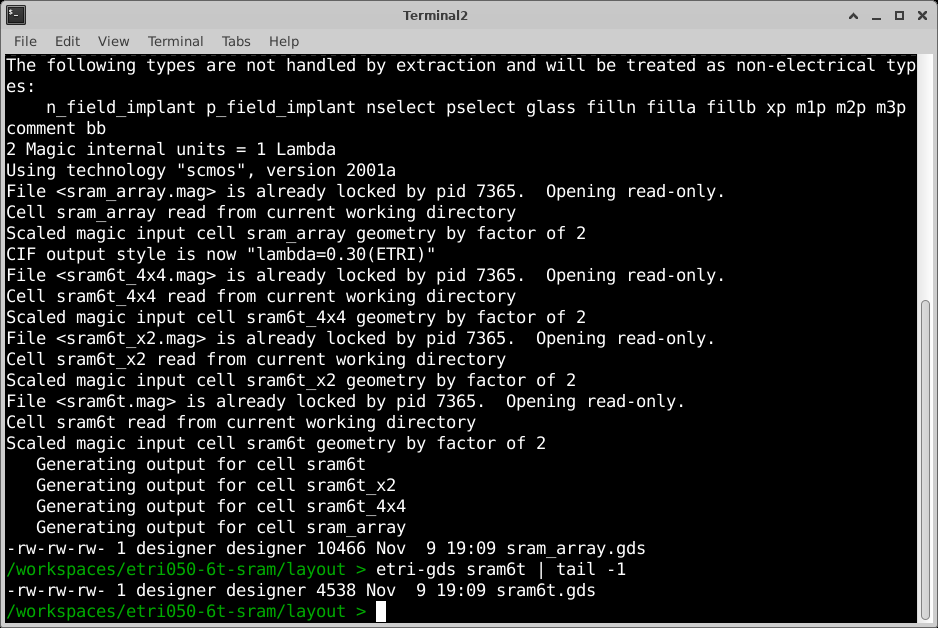
docs/img/32/gds_term.png
