mseokq23/etri050-6t-sram/docs/img/32/klayout_array.png

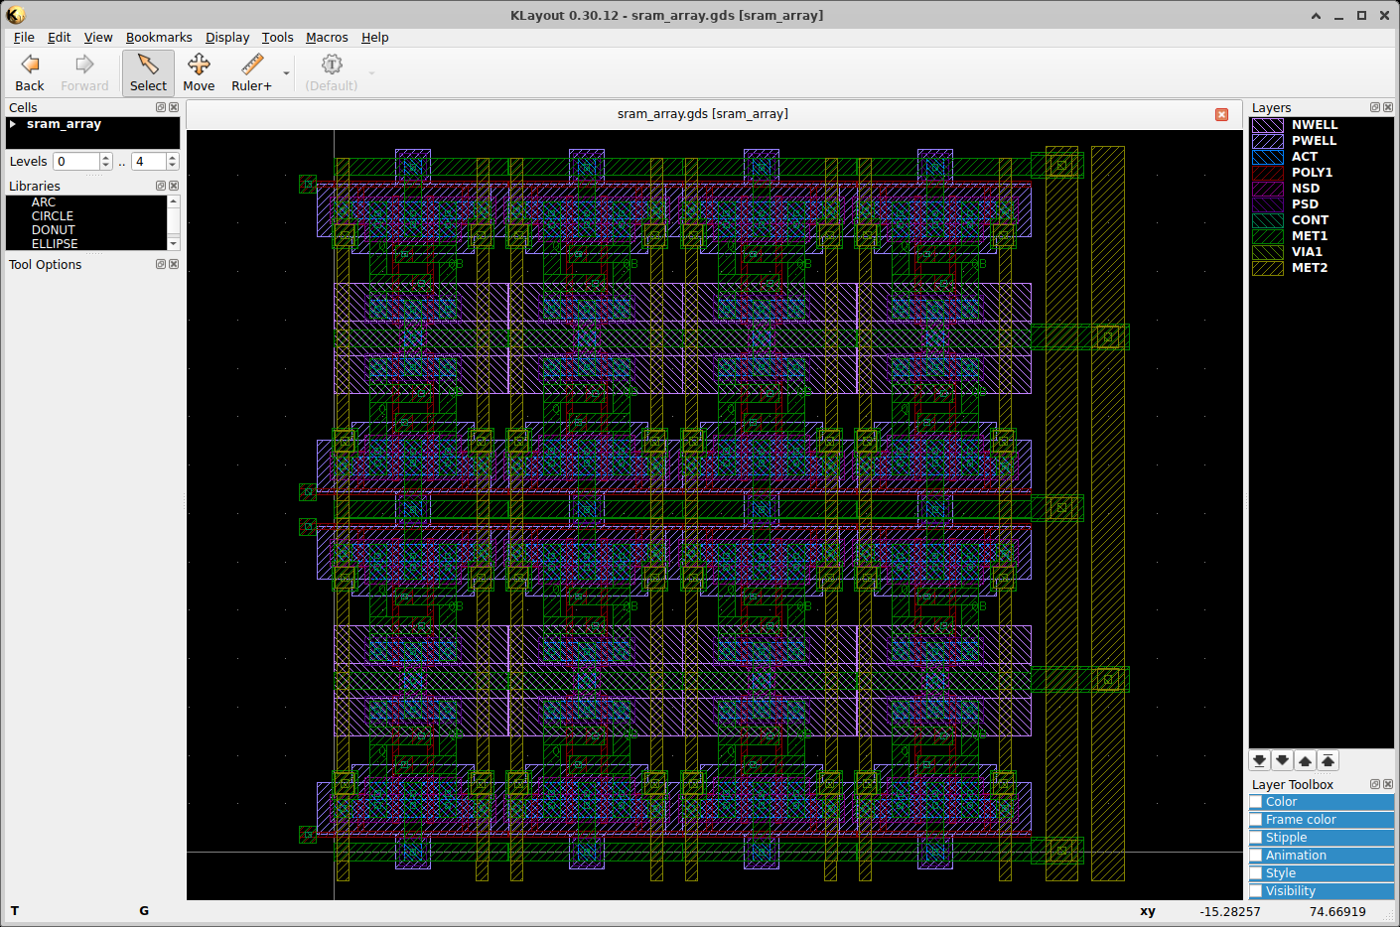
docs/img/32/klayout_array.png
