mseokq23/etri050-6t-sram/docs/img/33/klayout_drc_term.png

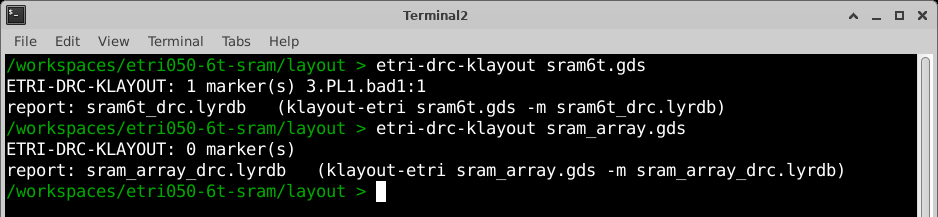
docs/img/33/klayout_drc_term.png
