mseokq23/etri050-6t-sram/docs/img/33/klayout_marker_layout.png

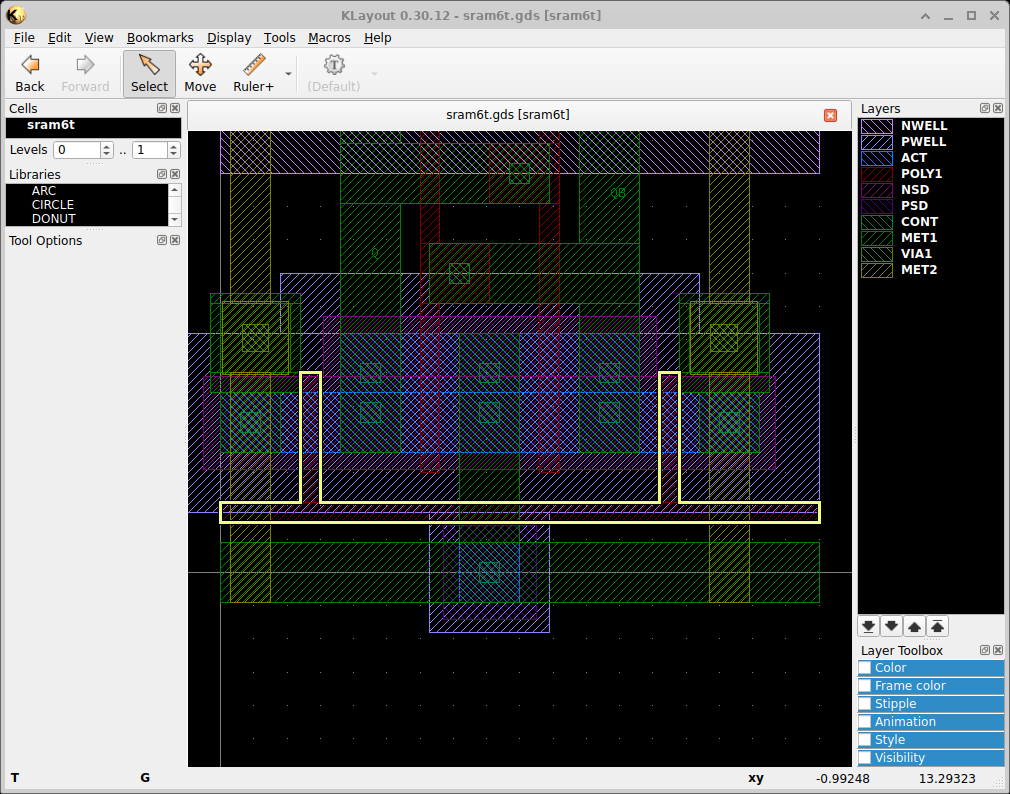
docs/img/33/klayout_marker_layout.png
