mseokq23/etri050-6t-sram/sram64x4/docs/img/01/chip_klayout.png

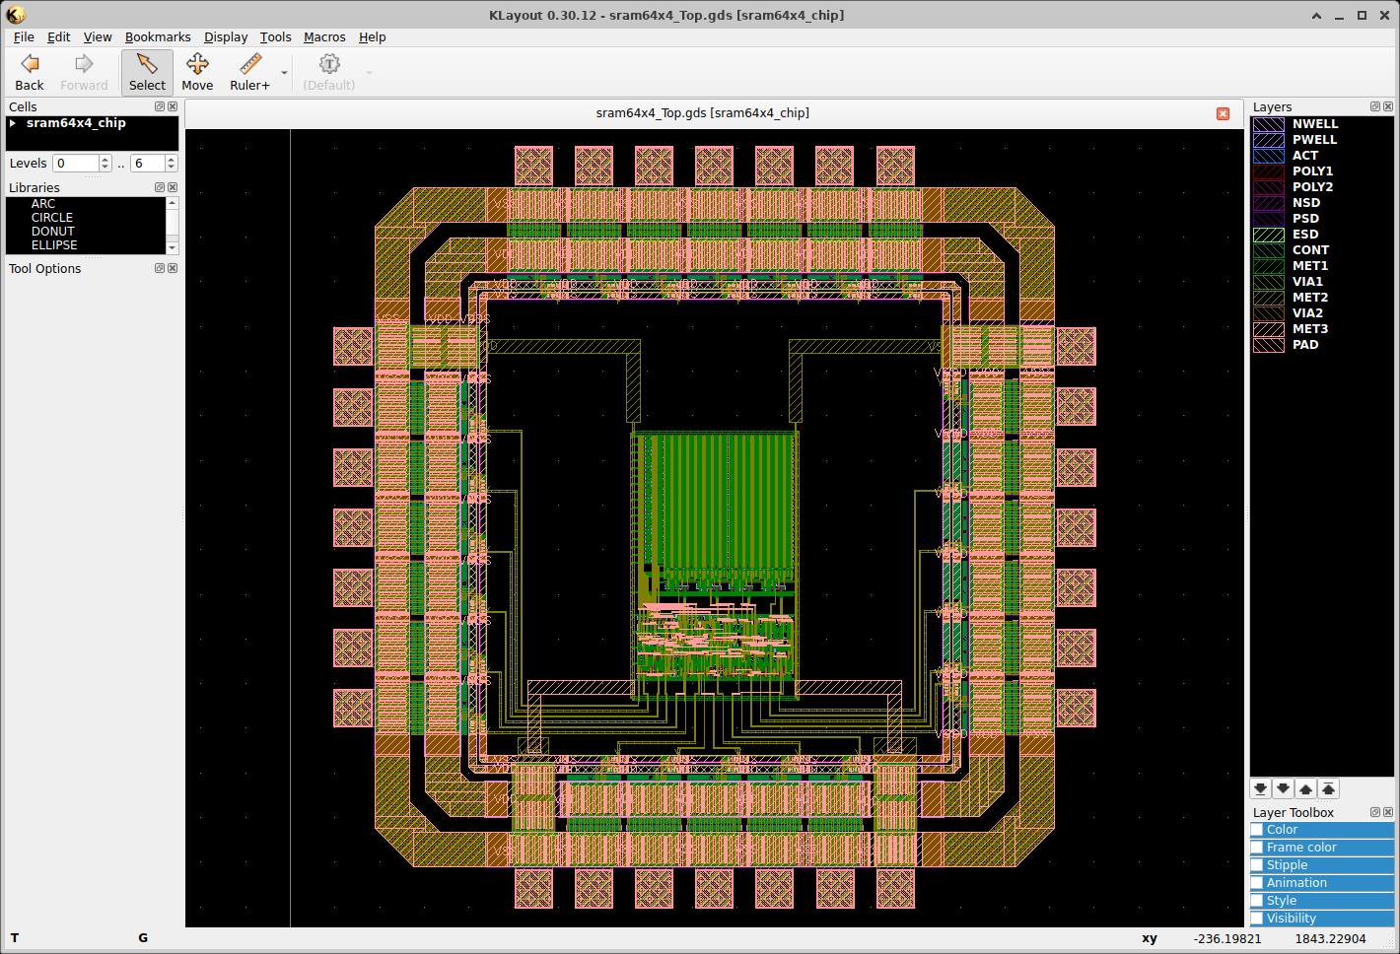
sram64x4/docs/img/01/chip_klayout.png
