mseokq23/etri050-6t-sram/sram64x4/docs/img/02/env_check.png

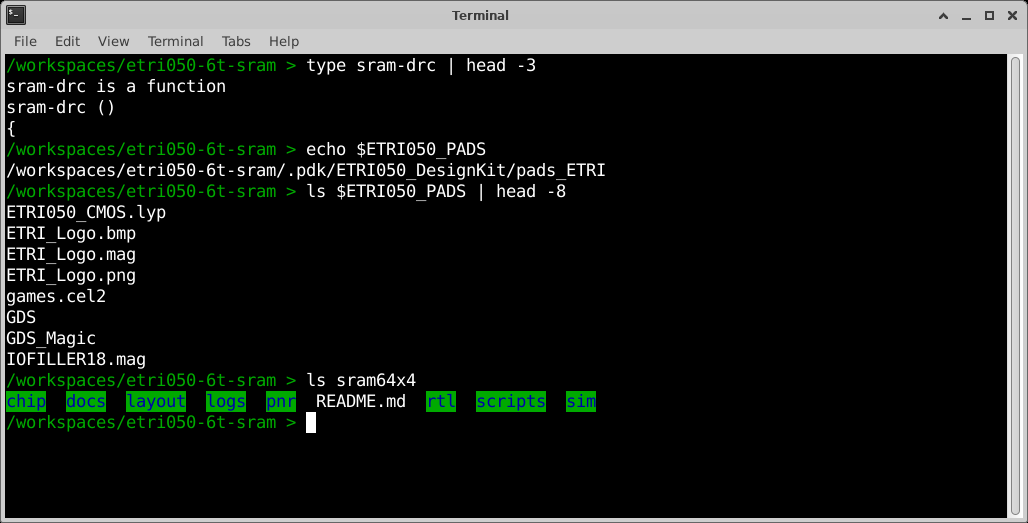
sram64x4/docs/img/02/env_check.png
