mseokq23/etri050-6t-sram/sram64x4/docs/img/03/block.png

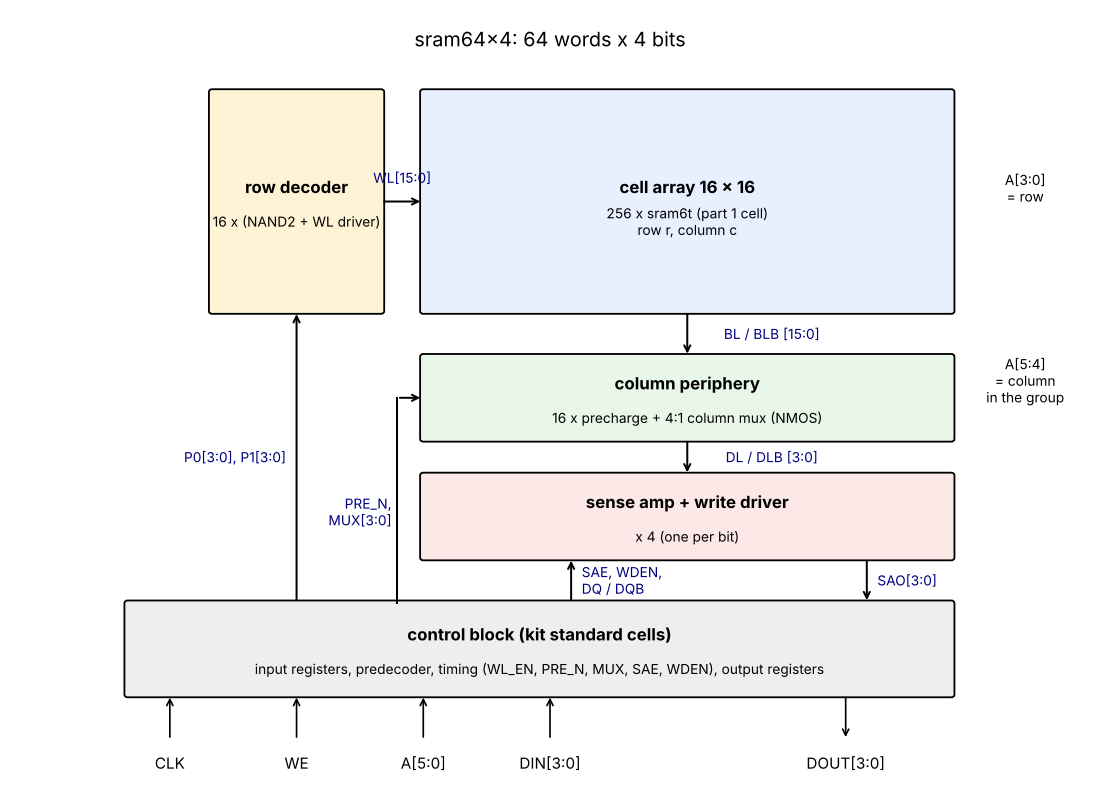
sram64x4/docs/img/03/block.png
