mseokq23/etri050-6t-sram/sram64x4/docs/img/03/timing.png

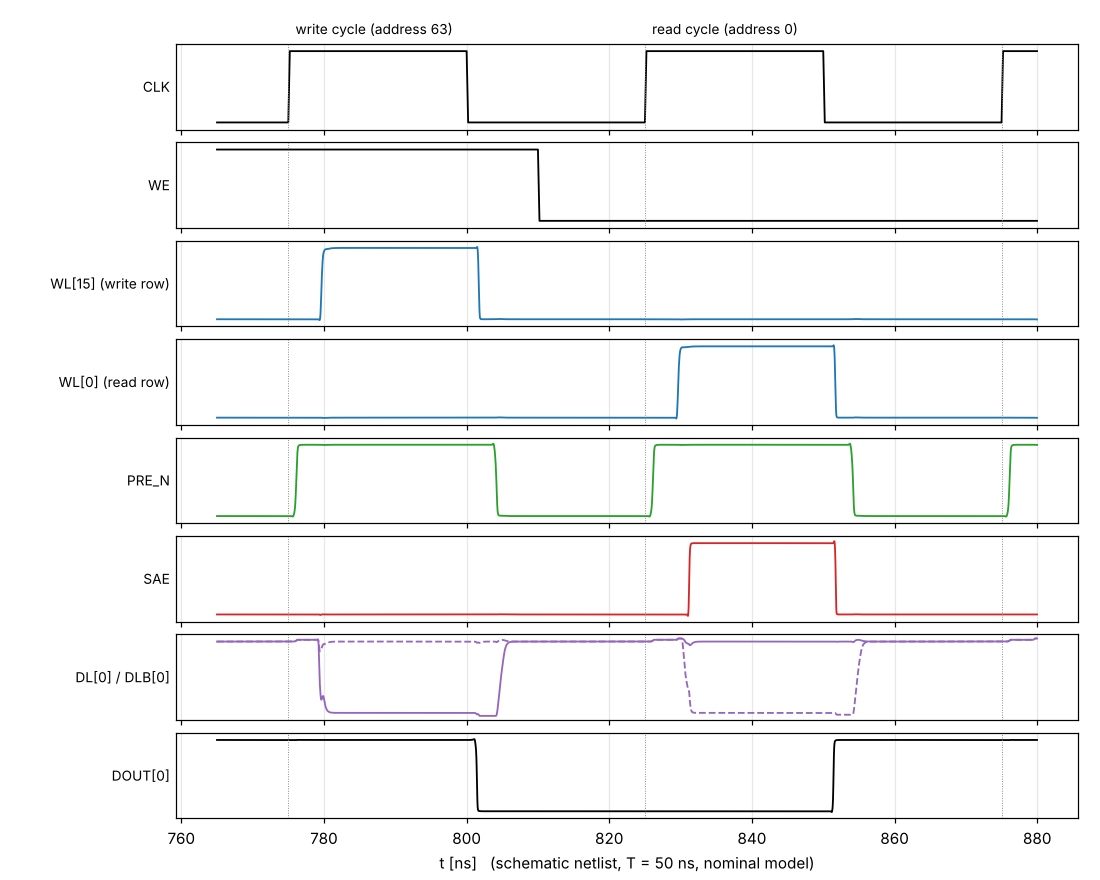
sram64x4/docs/img/03/timing.png
