mseokq23/etri050-6t-sram/sram64x4/docs/img/04/rowdrv.png

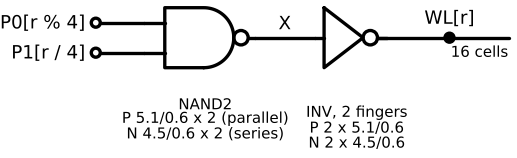
sram64x4/docs/img/04/rowdrv.png
