mseokq23/etri050-6t-sram/sram64x4/docs/img/05/rowdrv_rise.png

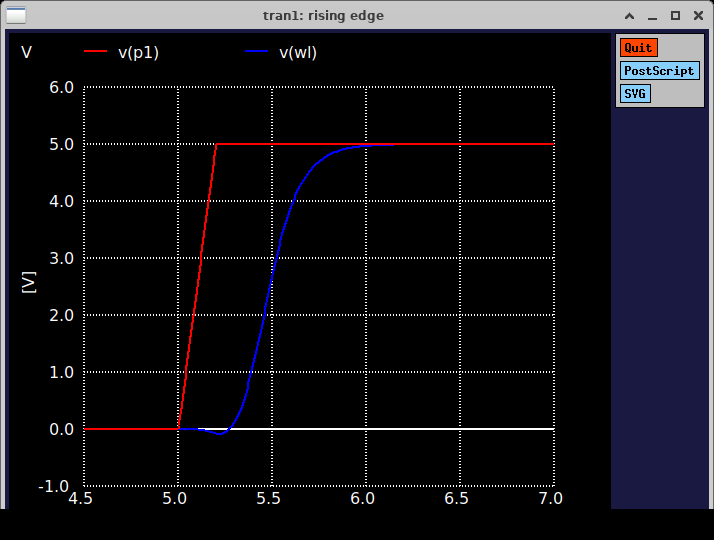
sram64x4/docs/img/05/rowdrv_rise.png
