mseokq23/etri050-6t-sram/sram64x4/docs/img/06/column_plot.png

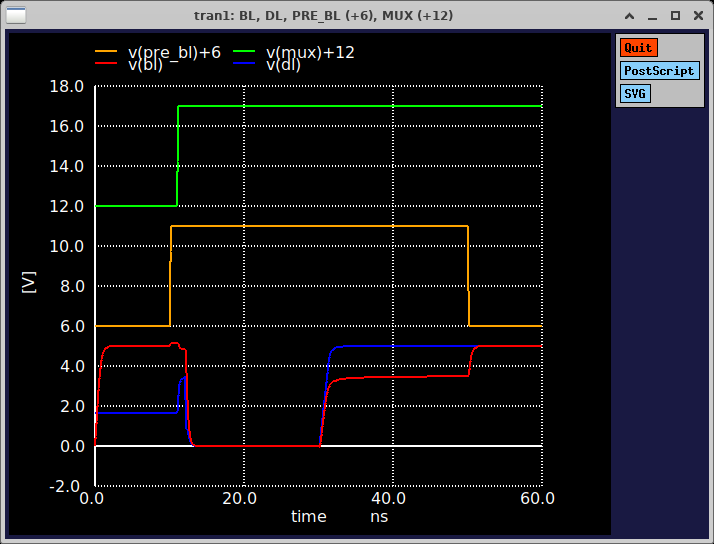
sram64x4/docs/img/06/column_plot.png
