mseokq23/etri050-6t-sram/sram64x4/docs/img/06/pchg_cmux.png

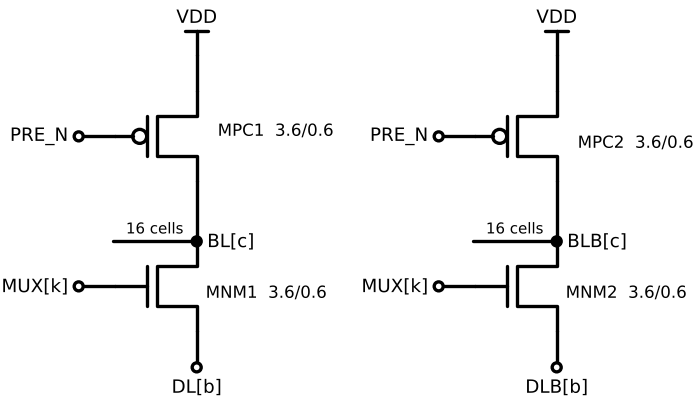
sram64x4/docs/img/06/pchg_cmux.png
