mseokq23/etri050-6t-sram/sram64x4/docs/img/07/bitslice_read.png

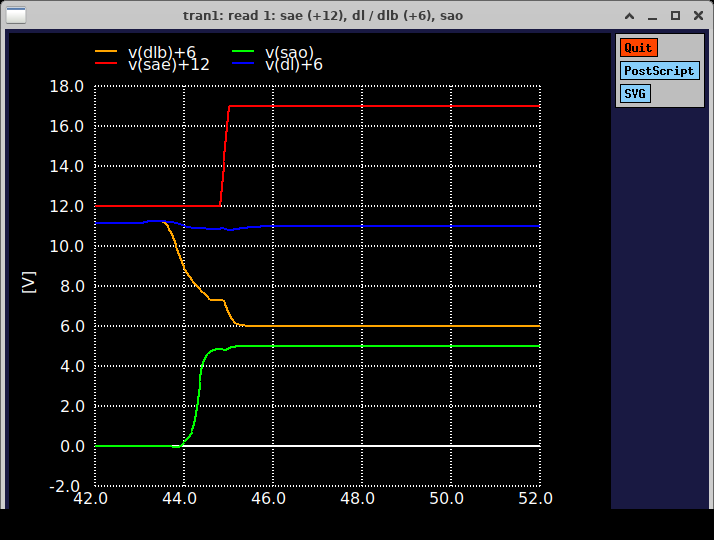
sram64x4/docs/img/07/bitslice_read.png
