mseokq23/etri050-6t-sram/sram64x4/docs/img/08/sae_sweep_term.png

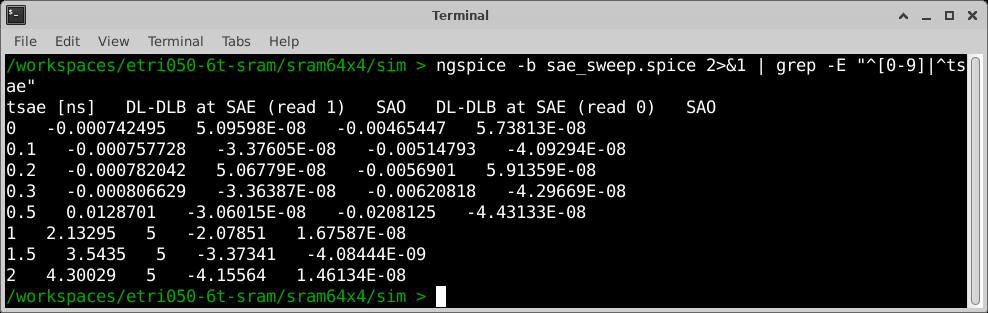
sram64x4/docs/img/08/sae_sweep_term.png
