mseokq23/etri050-6t-sram/sram64x4/docs/img/09/bitslice_write.png

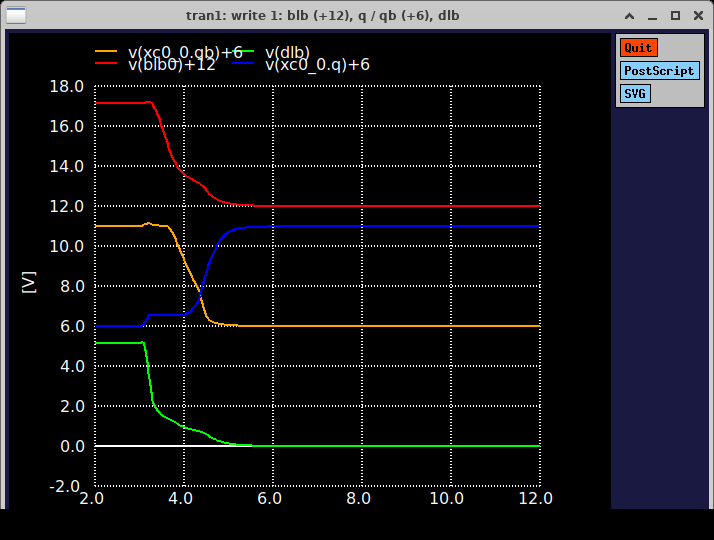
sram64x4/docs/img/09/bitslice_write.png
