mseokq23/etri050-6t-sram/sram64x4/docs/img/10/ctrl_spice_term.png

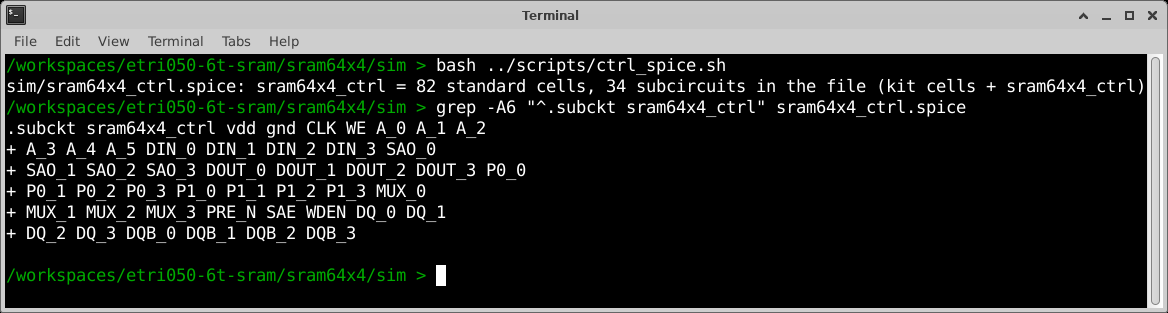
sram64x4/docs/img/10/ctrl_spice_term.png
