mseokq23/etri050-6t-sram/sram64x4/docs/img/11/ctrl_rw.png

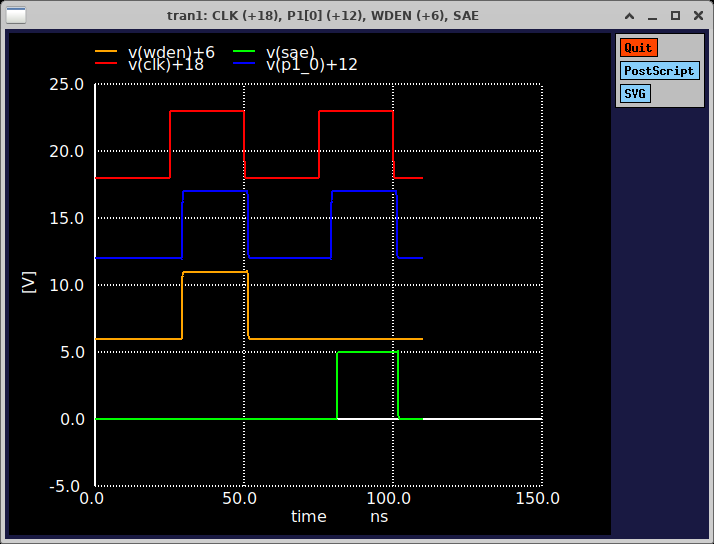
sram64x4/docs/img/11/ctrl_rw.png
