mseokq23/etri050-6t-sram/sram64x4/docs/img/12/macro_sim_term.png

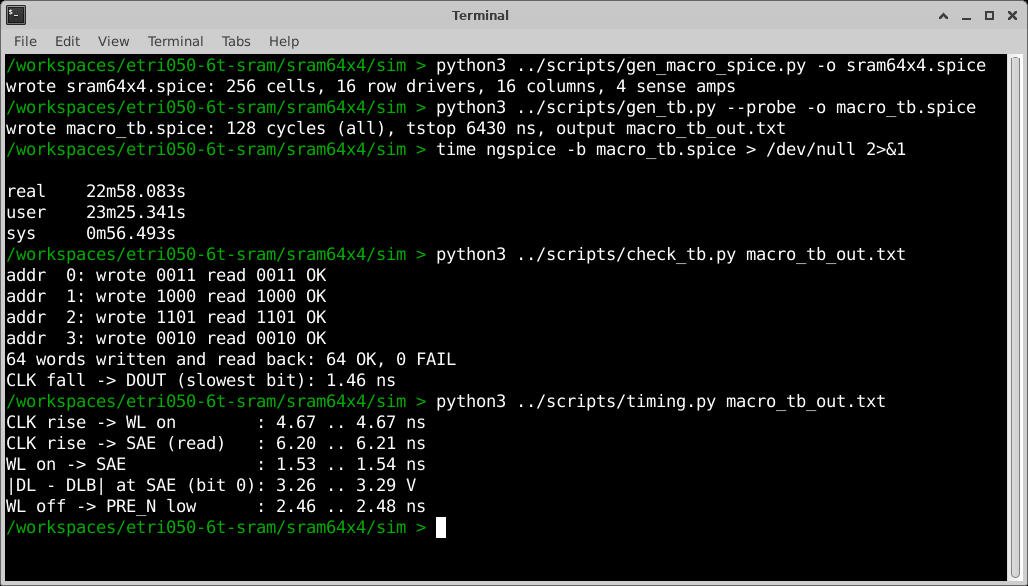
sram64x4/docs/img/12/macro_sim_term.png
