mseokq23/etri050-6t-sram/sram64x4/docs/img/13/corner_iv_term.png

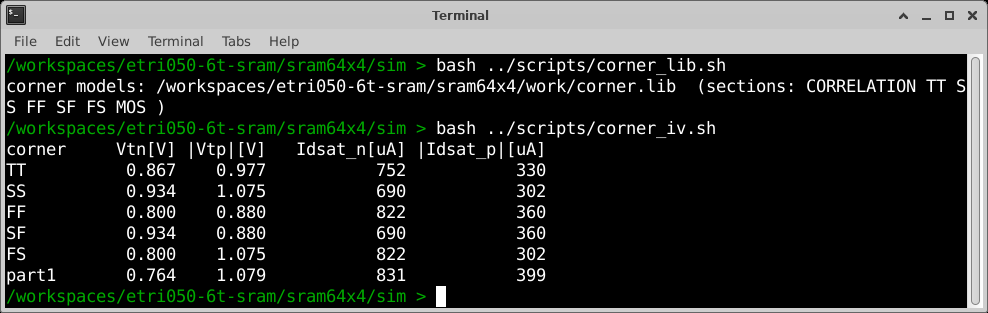
sram64x4/docs/img/13/corner_iv_term.png
