mseokq23/etri050-6t-sram/sram64x4/docs/img/14/cell_corners.png

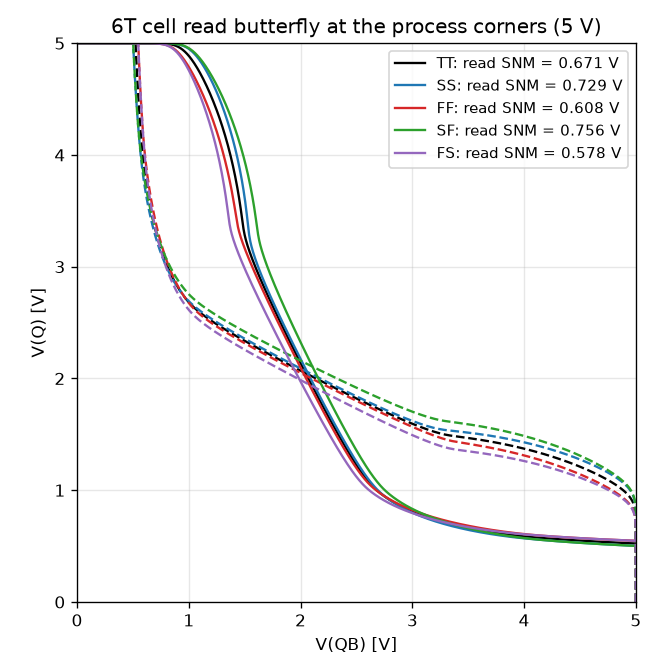
sram64x4/docs/img/14/cell_corners.png
