mseokq23/etri050-6t-sram/sram64x4/docs/img/15/macro_corners_term.png

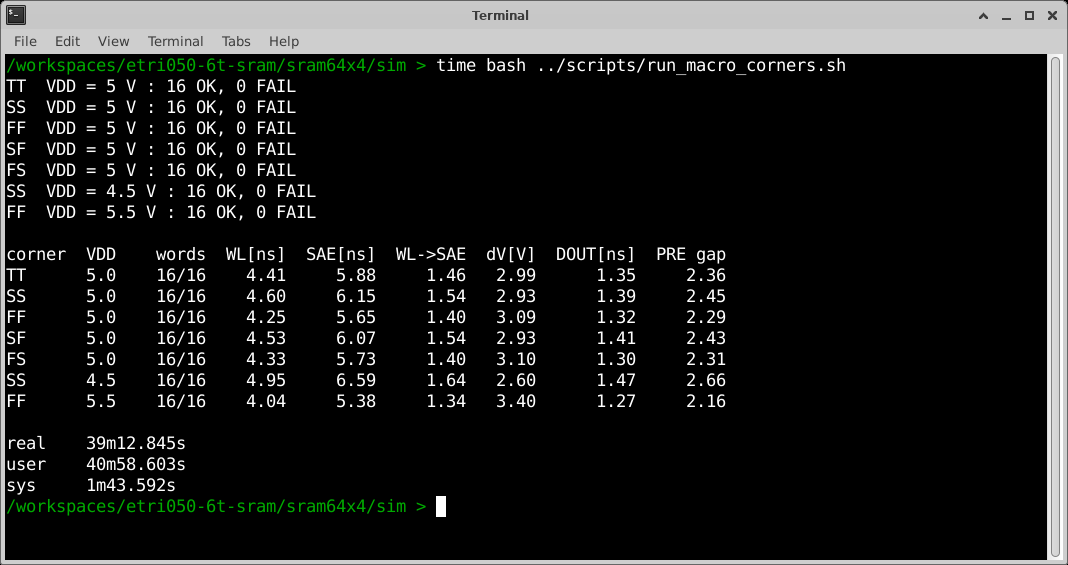
sram64x4/docs/img/15/macro_corners_term.png
