mseokq23/etri050-6t-sram/sram64x4/docs/img/16/floorplan.png

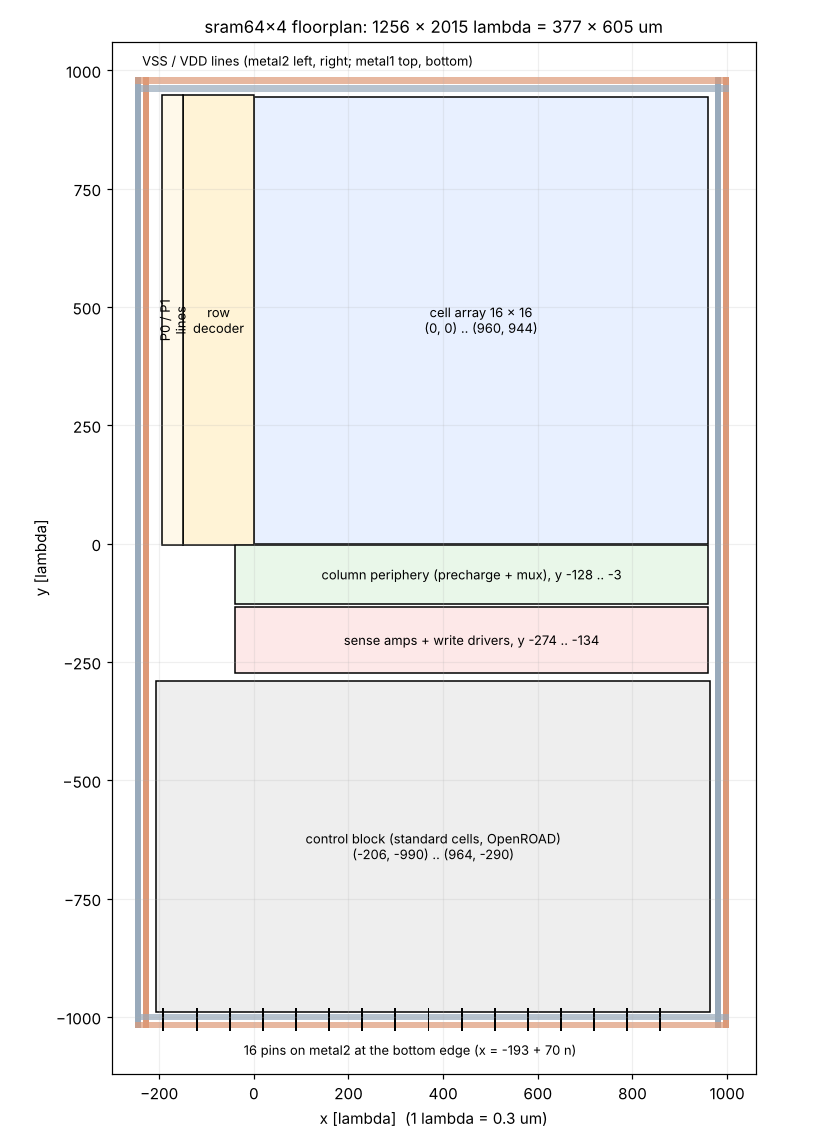
sram64x4/docs/img/16/floorplan.png
