mseokq23/etri050-6t-sram/sram64x4/docs/img/16/macro.png

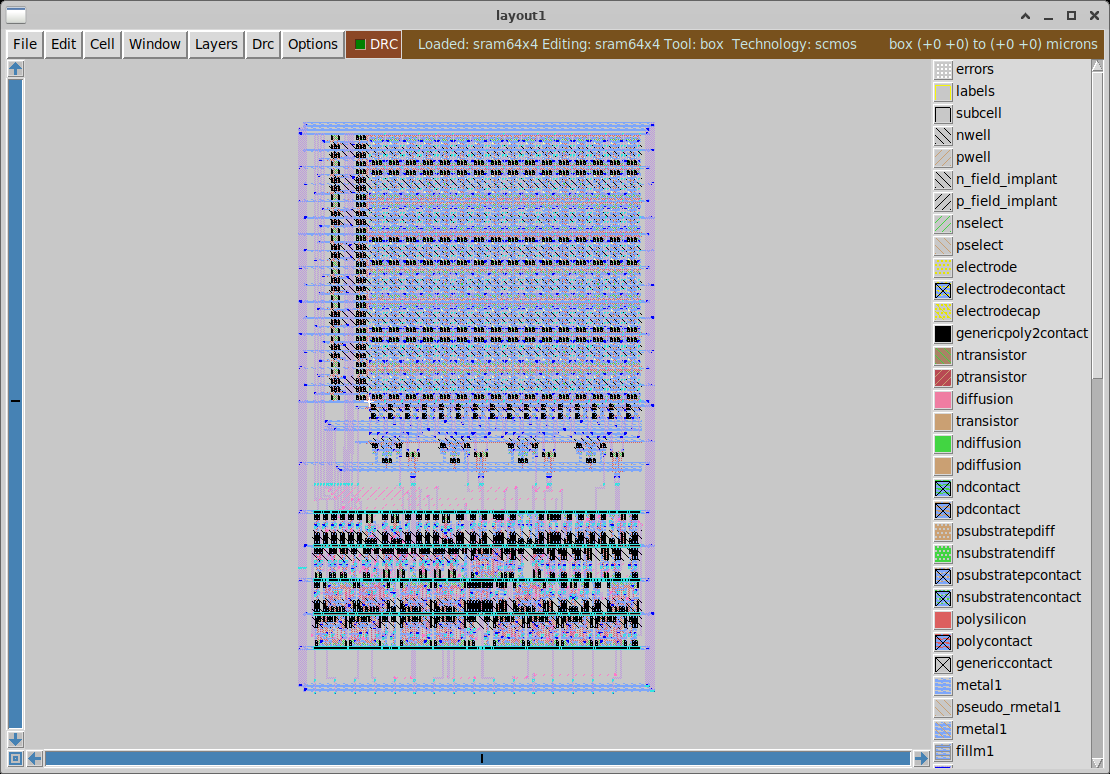
sram64x4/docs/img/16/macro.png
