mseokq23/etri050-6t-sram/sram64x4/docs/img/17/array.png

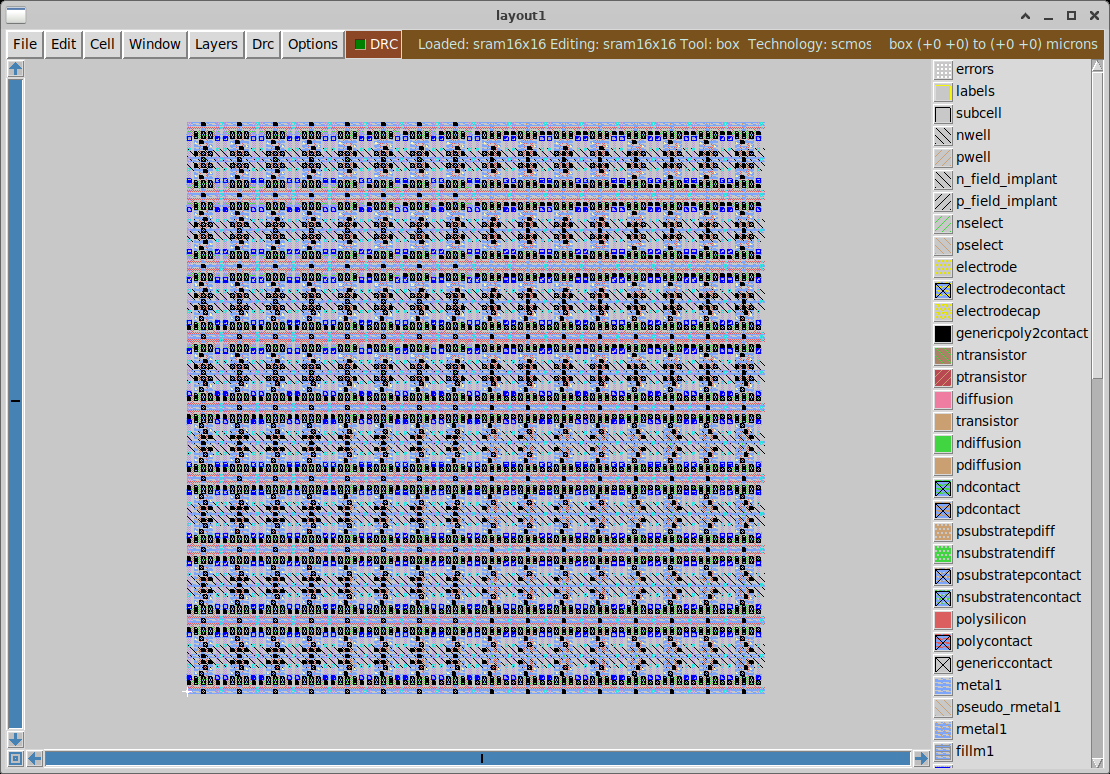
sram64x4/docs/img/17/array.png
