mseokq23/etri050-6t-sram/sram64x4/docs/img/17/array_corner.png

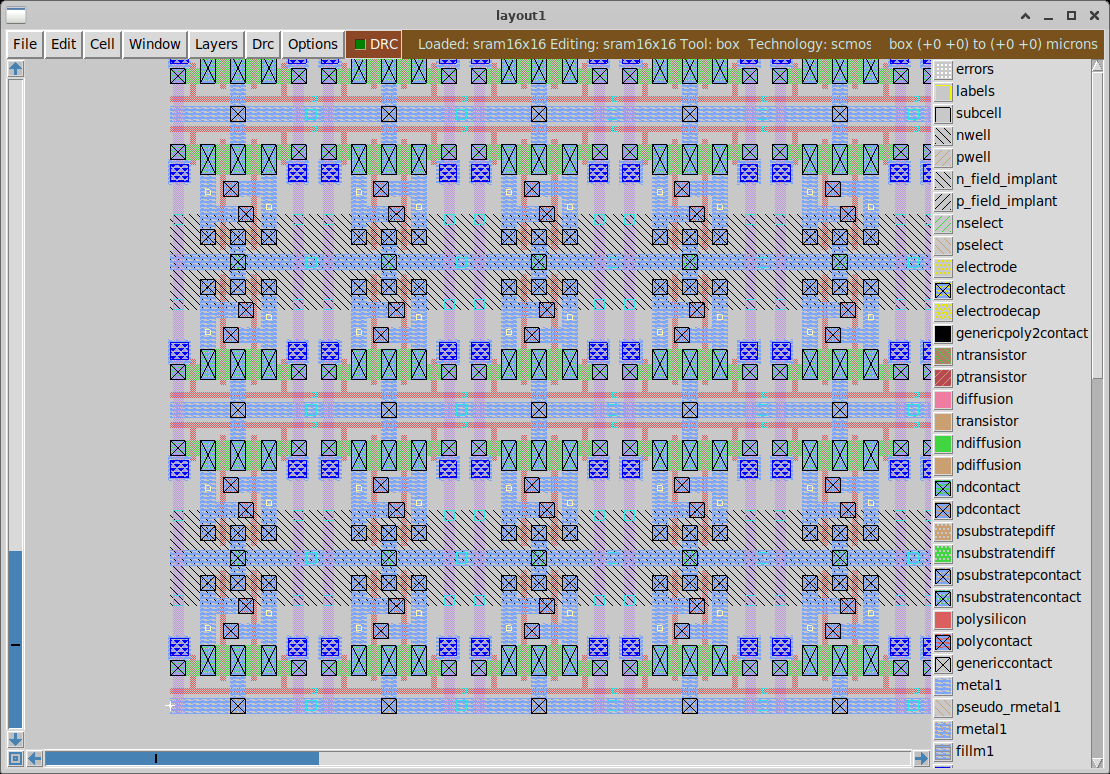
sram64x4/docs/img/17/array_corner.png
