mseokq23/etri050-6t-sram/sram64x4/docs/img/18/rowdec_bottom.png

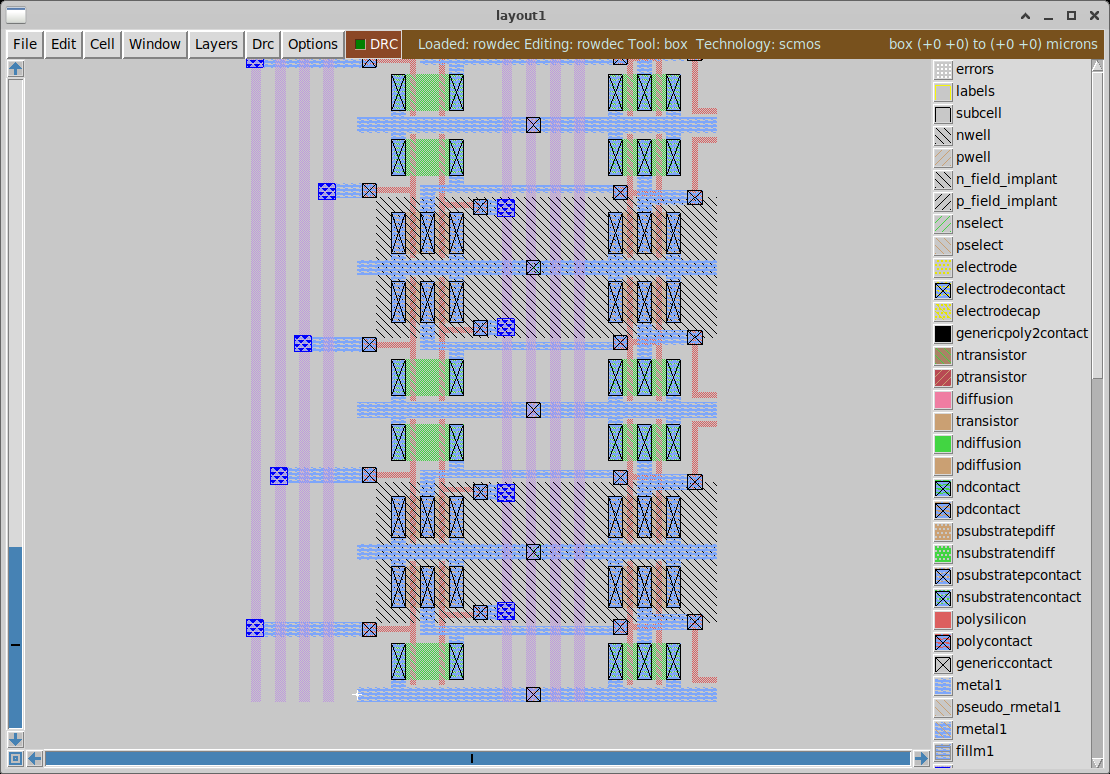
sram64x4/docs/img/18/rowdec_bottom.png
