mseokq23/etri050-6t-sram/sram64x4/docs/img/19/rowdec_check_term.png

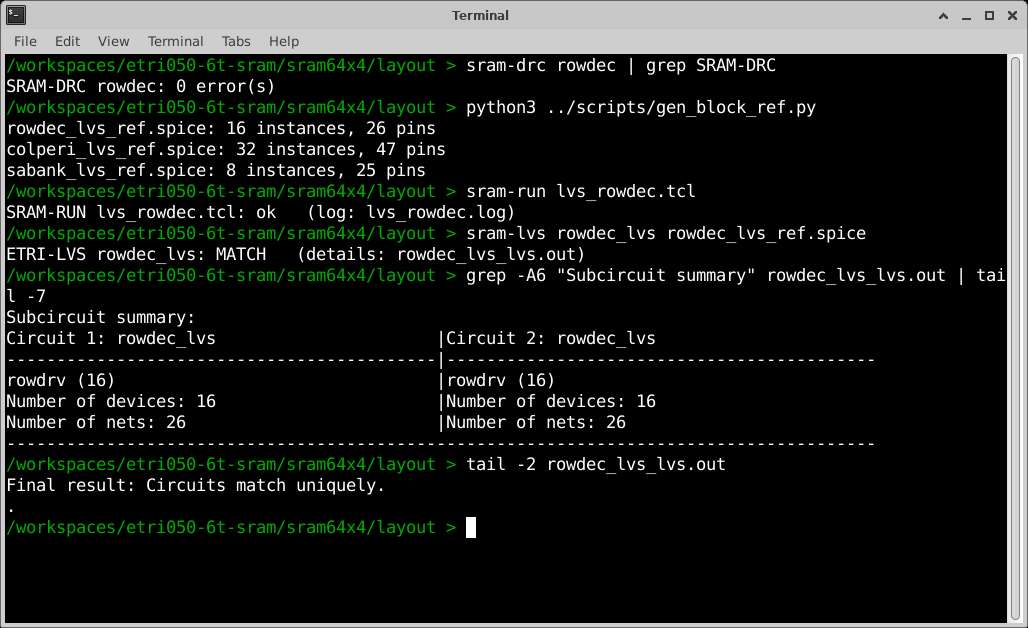
sram64x4/docs/img/19/rowdec_check_term.png
