mseokq23/etri050-6t-sram/sram64x4/docs/img/20/colperi_left.png

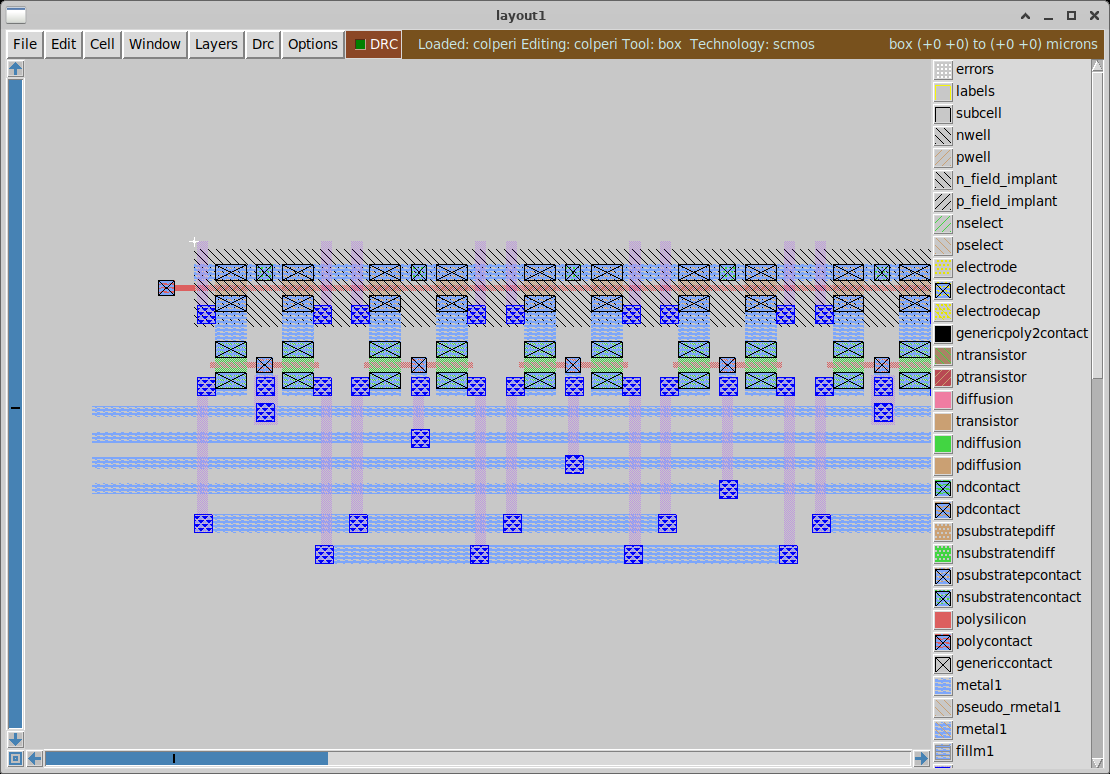
sram64x4/docs/img/20/colperi_left.png
