mseokq23/etri050-6t-sram/sram64x4/docs/img/21/sabit.png

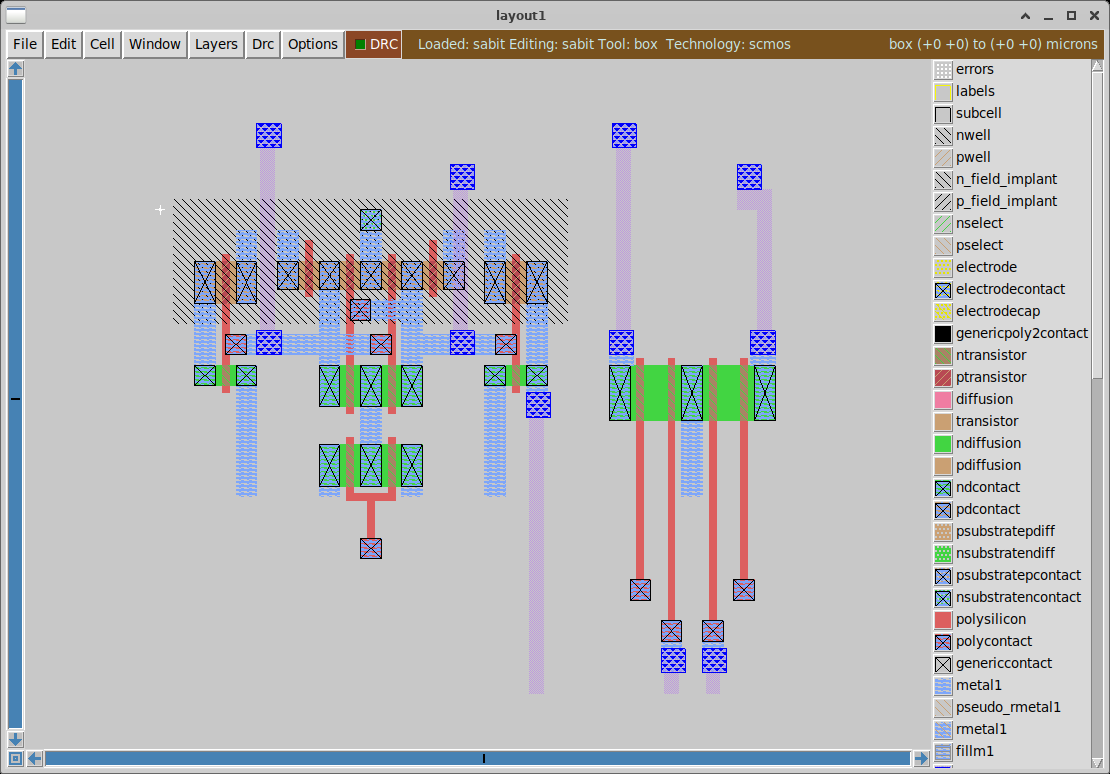
sram64x4/docs/img/21/sabit.png
