mseokq23/etri050-6t-sram/sram64x4/docs/img/23/ctrl_check_term.png

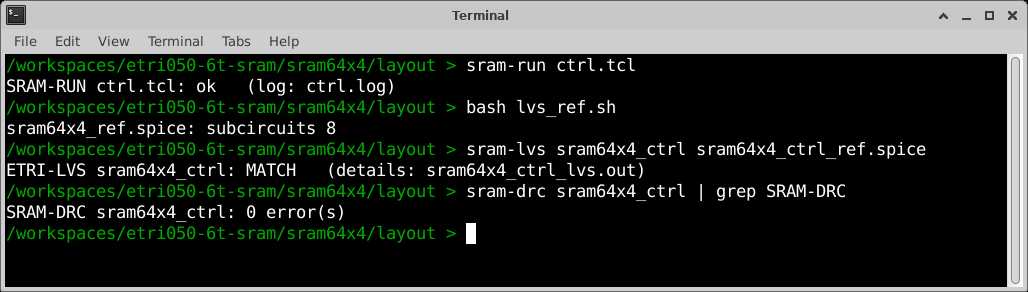
sram64x4/docs/img/23/ctrl_check_term.png
