mseokq23/etri050-6t-sram/sram64x4/docs/img/24/routes_left_bottom.png

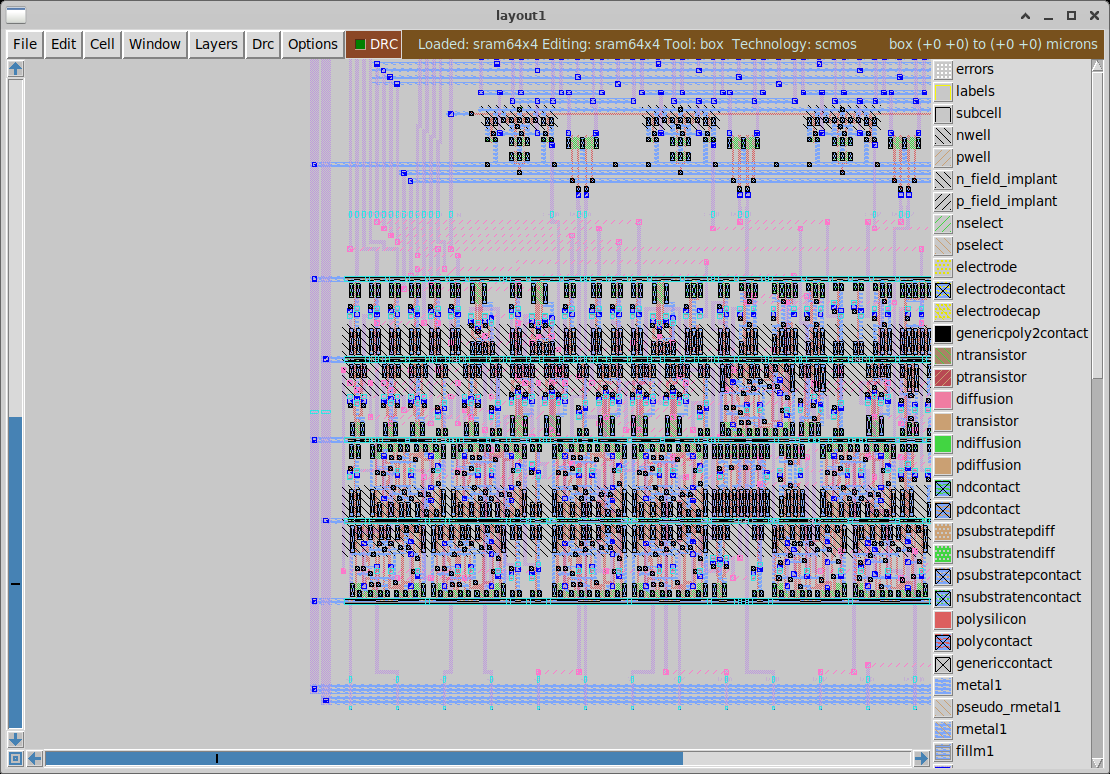
sram64x4/docs/img/24/routes_left_bottom.png
