mseokq23/etri050-6t-sram/sram64x4/docs/img/26/pex_term.png

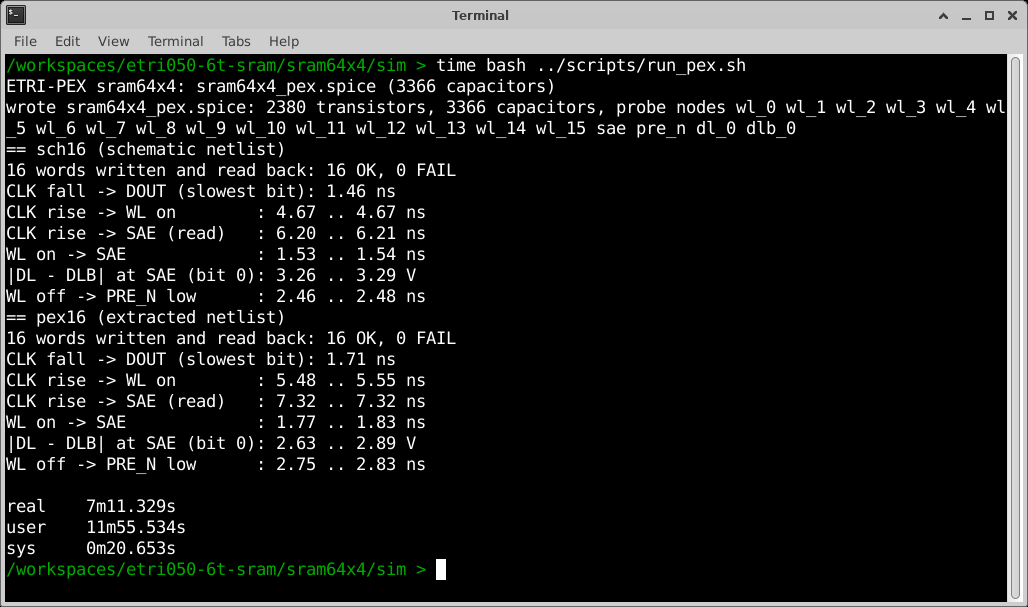
sram64x4/docs/img/26/pex_term.png
