mseokq23/etri050-6t-sram/sram64x4/docs/img/27/gds_drc_term.png

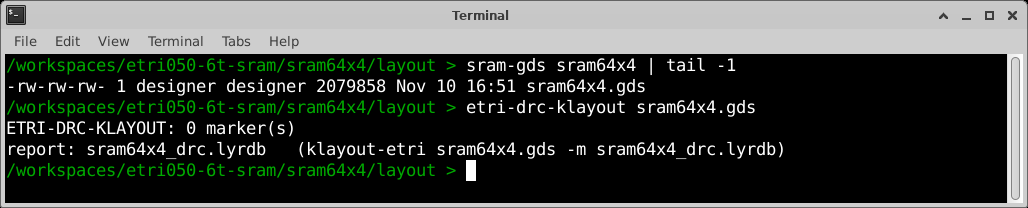
sram64x4/docs/img/27/gds_drc_term.png
