mseokq23/etri050-6t-sram/sram64x4/docs/img/27/macro_klayout.png

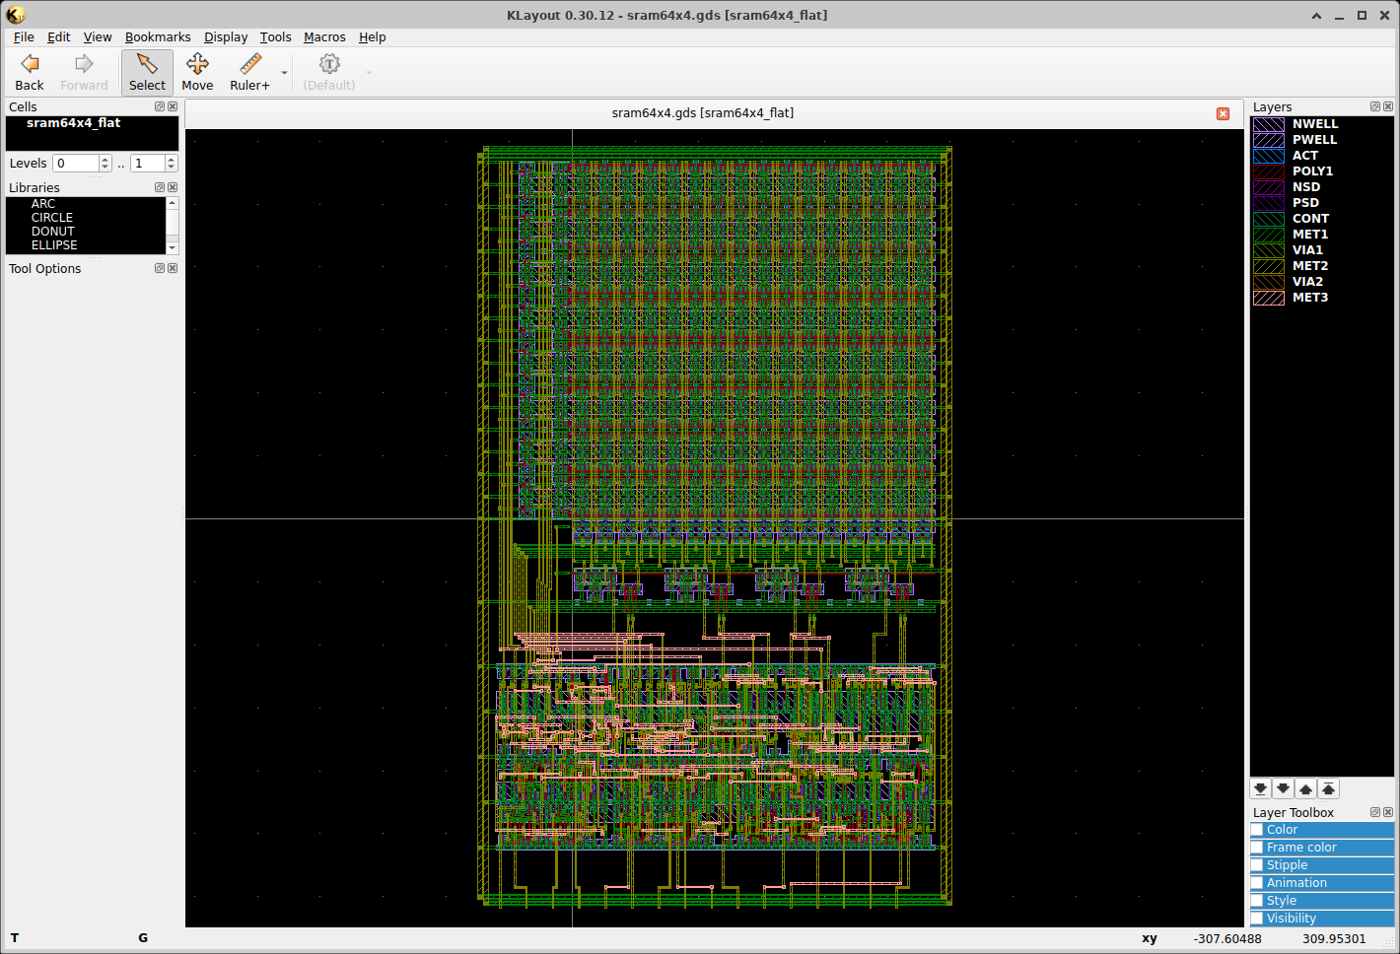
sram64x4/docs/img/27/macro_klayout.png
