mseokq23/etri050-6t-sram/sram64x4/docs/img/28/pad_frame.png

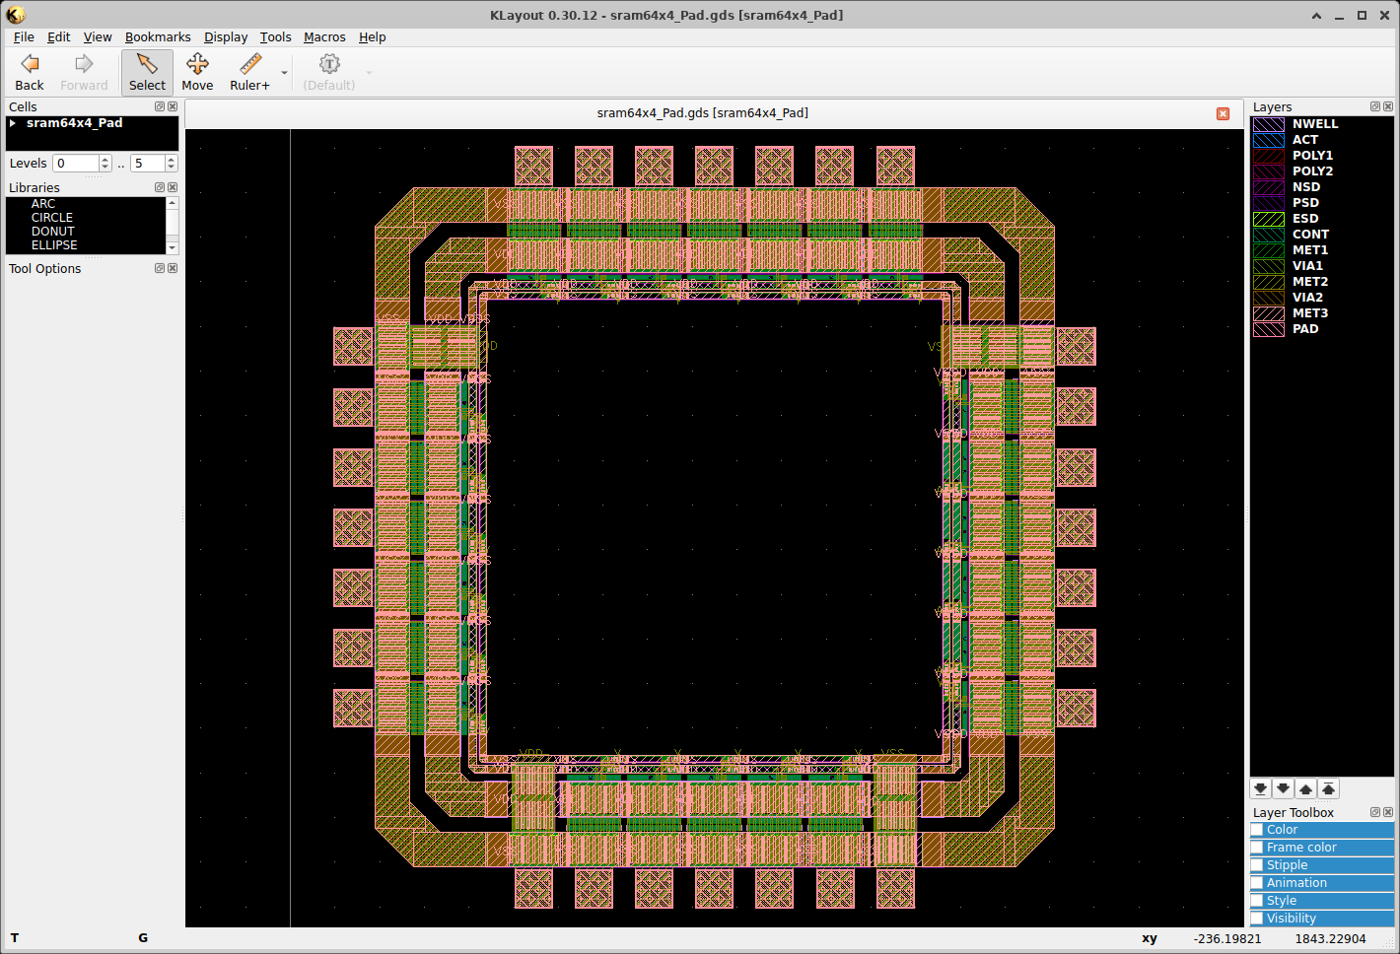
sram64x4/docs/img/28/pad_frame.png
