mseokq23/etri050-6t-sram/sram64x4/docs/img/28/pad_pin.png

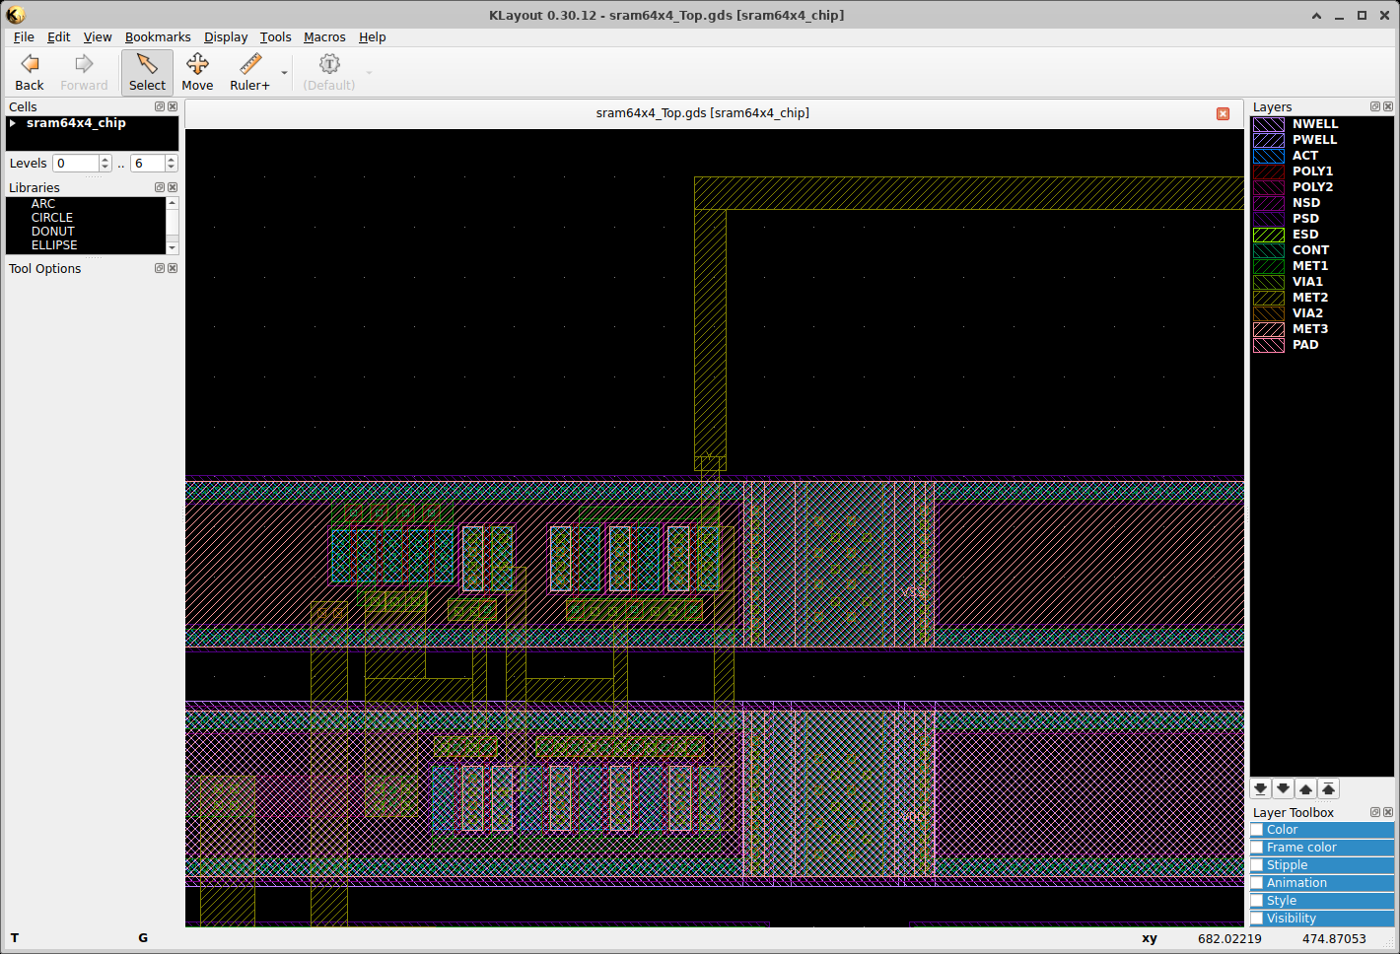
sram64x4/docs/img/28/pad_pin.png
