mseokq23/etri050-6t-sram/sram64x4/docs/img/29/power_top_left.png

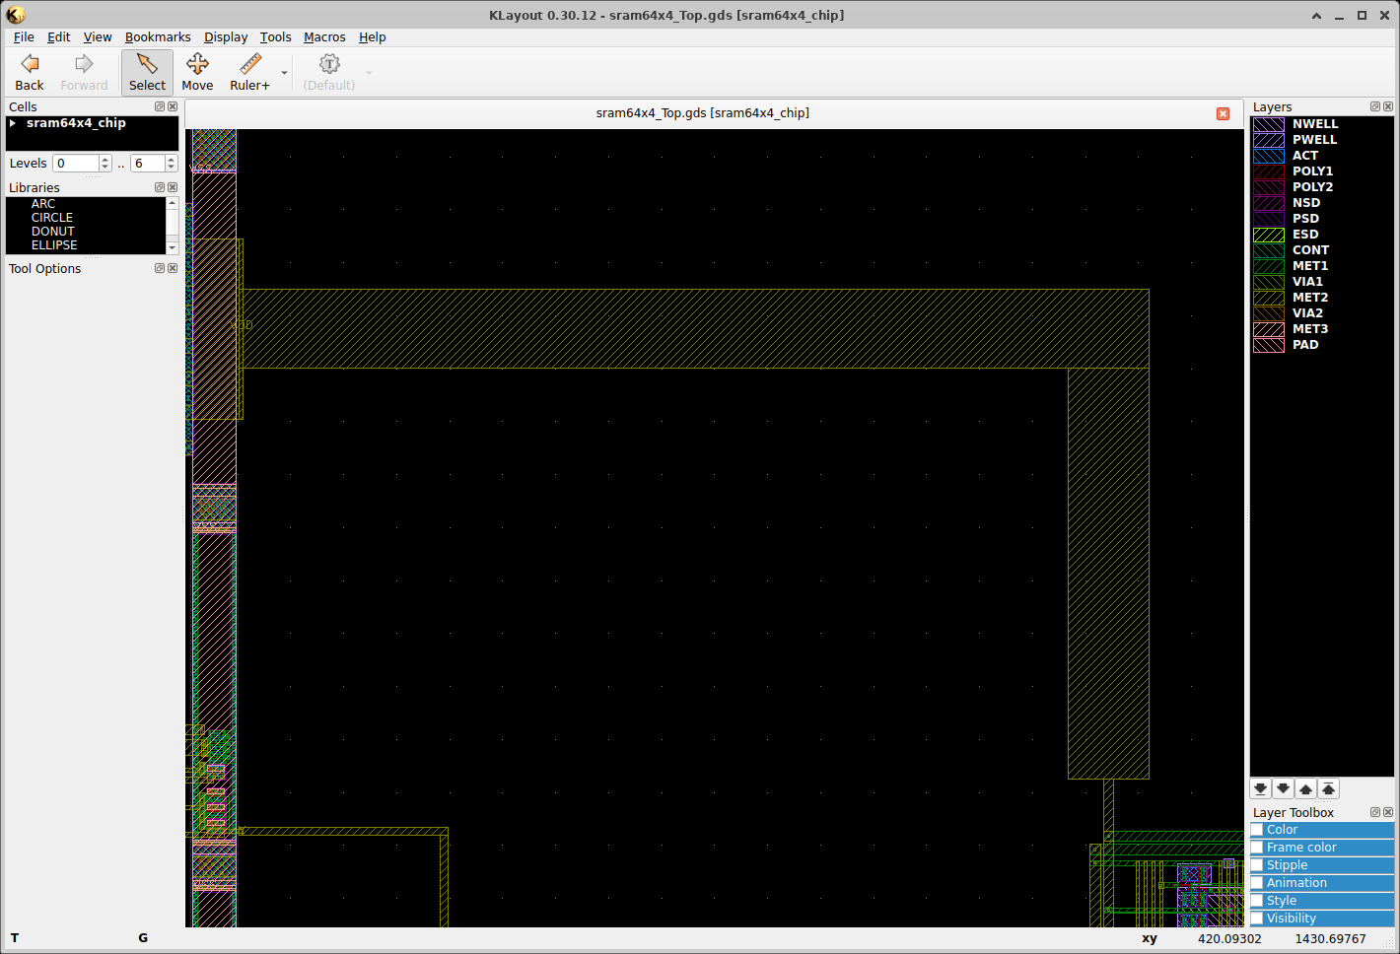
sram64x4/docs/img/29/power_top_left.png
