mseokq23/etri050-6t-sram/sram64x4/docs/img/30/bondpad_final.png

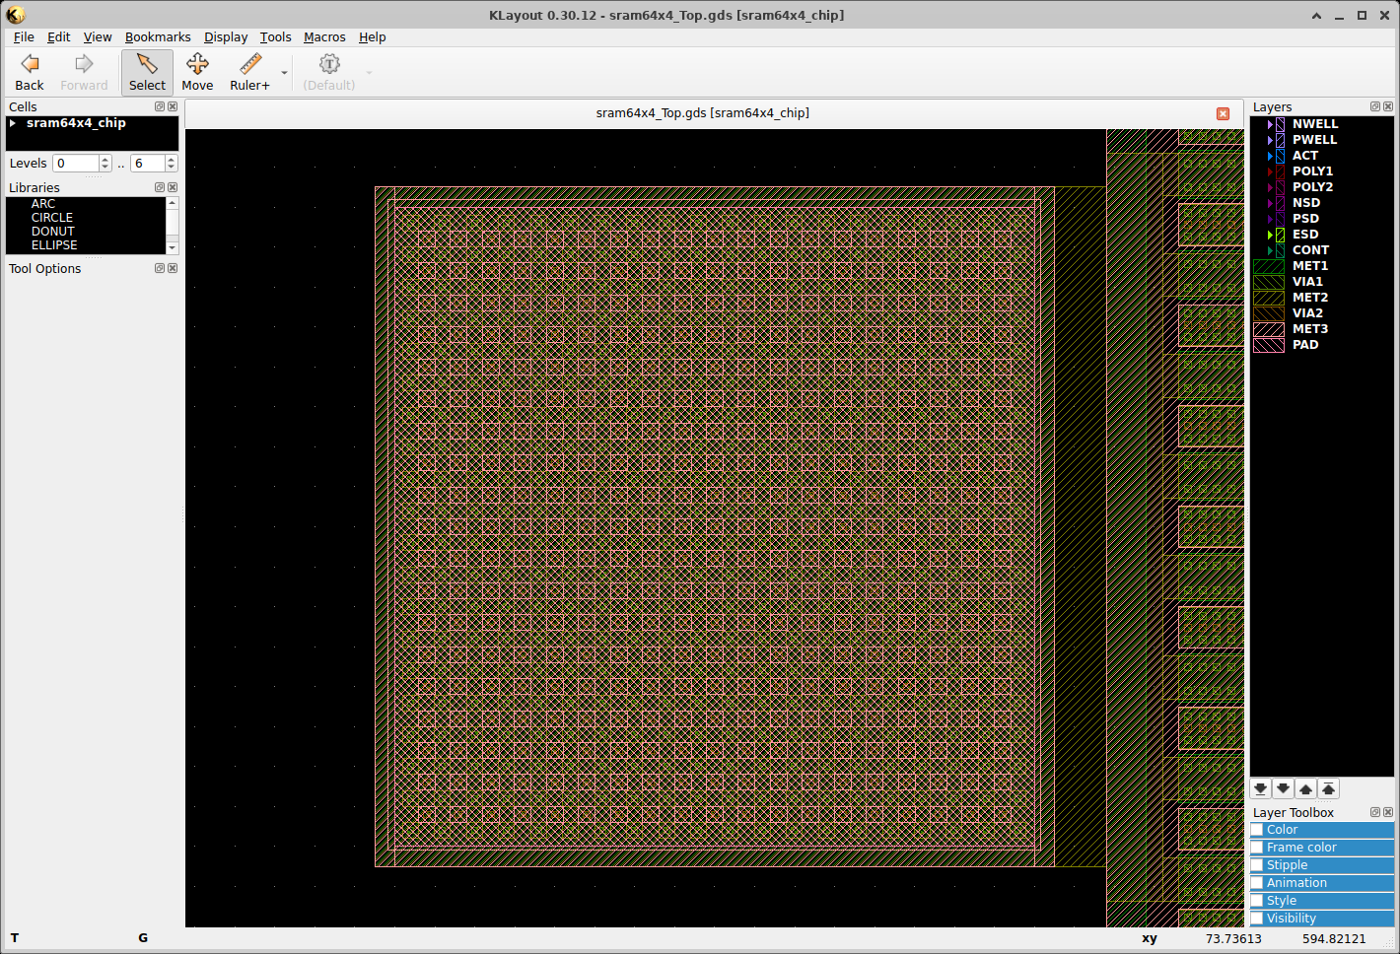
sram64x4/docs/img/30/bondpad_final.png
