mseokq23/etri050-6t-sram/sram64x4/docs/img/31/check_chip_term.png

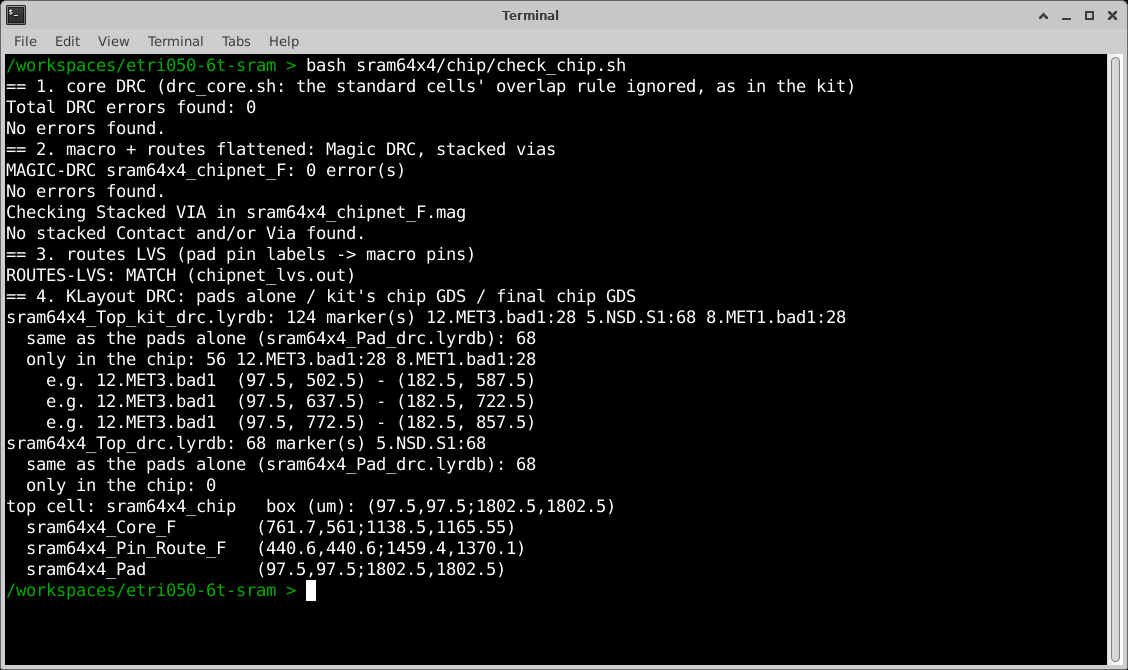
sram64x4/docs/img/31/check_chip_term.png
