mseokq23/etri050-6t-sram/docs/img/04/setup_run.png

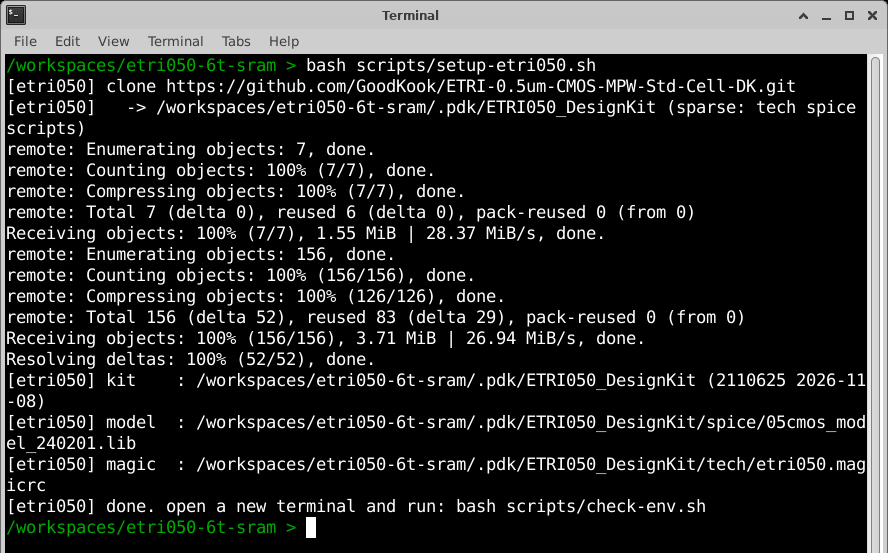
docs/img/04/setup_run.png
