mseokq23/etri050-6t-sram/docs/img/23/sram6t_step1_nmos.png

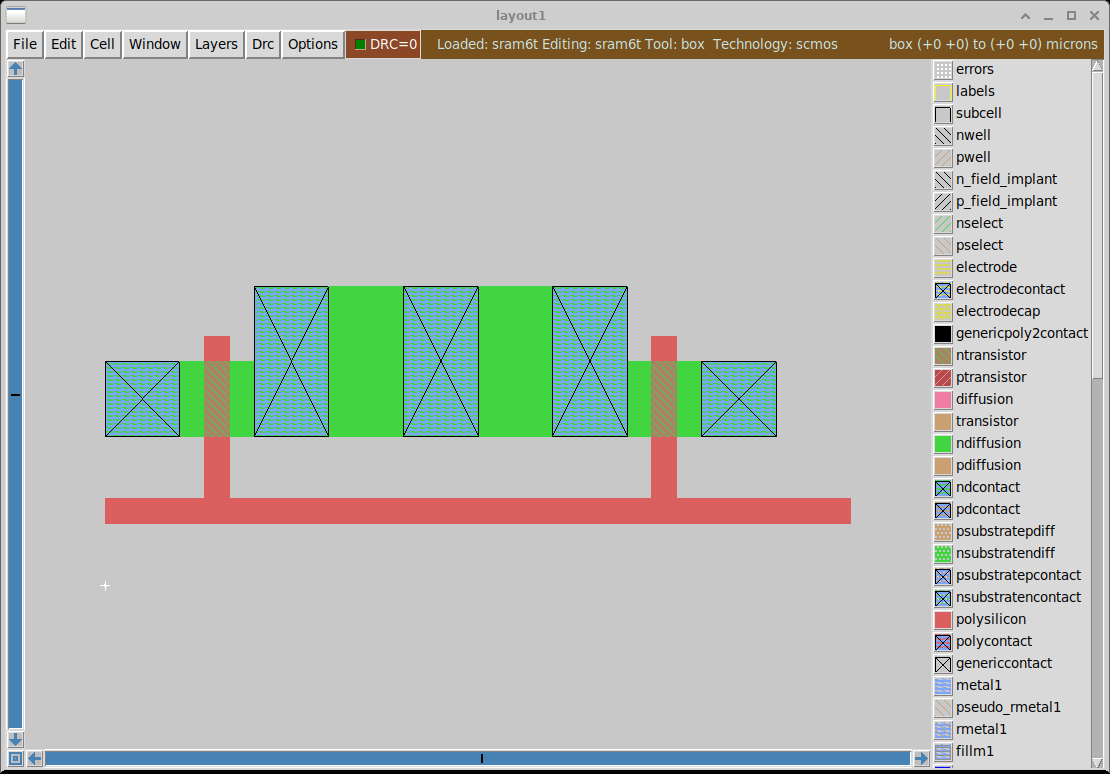
docs/img/23/sram6t_step1_nmos.png
