mseokq23/etri050-6t-sram/docs/img/24/sram6t_step2_pmos.png

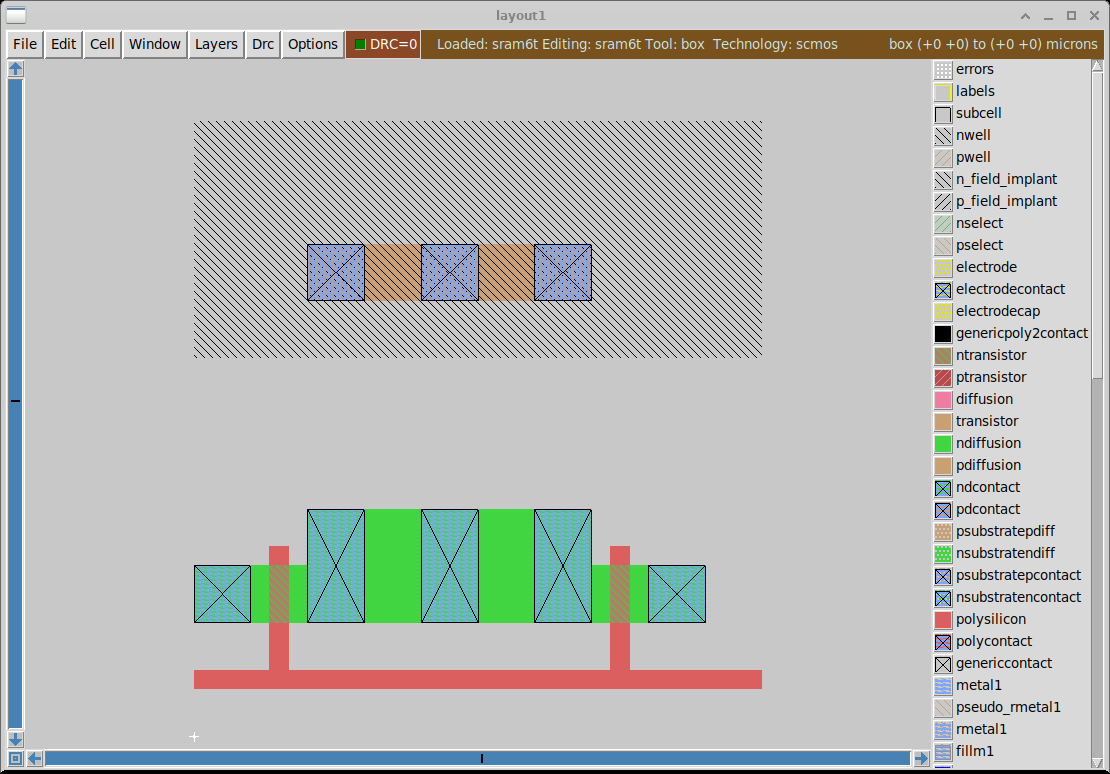
docs/img/24/sram6t_step2_pmos.png
