mseokq23/etri050-6t-sram/docs/img/25/sram6t_step4_metal1.png

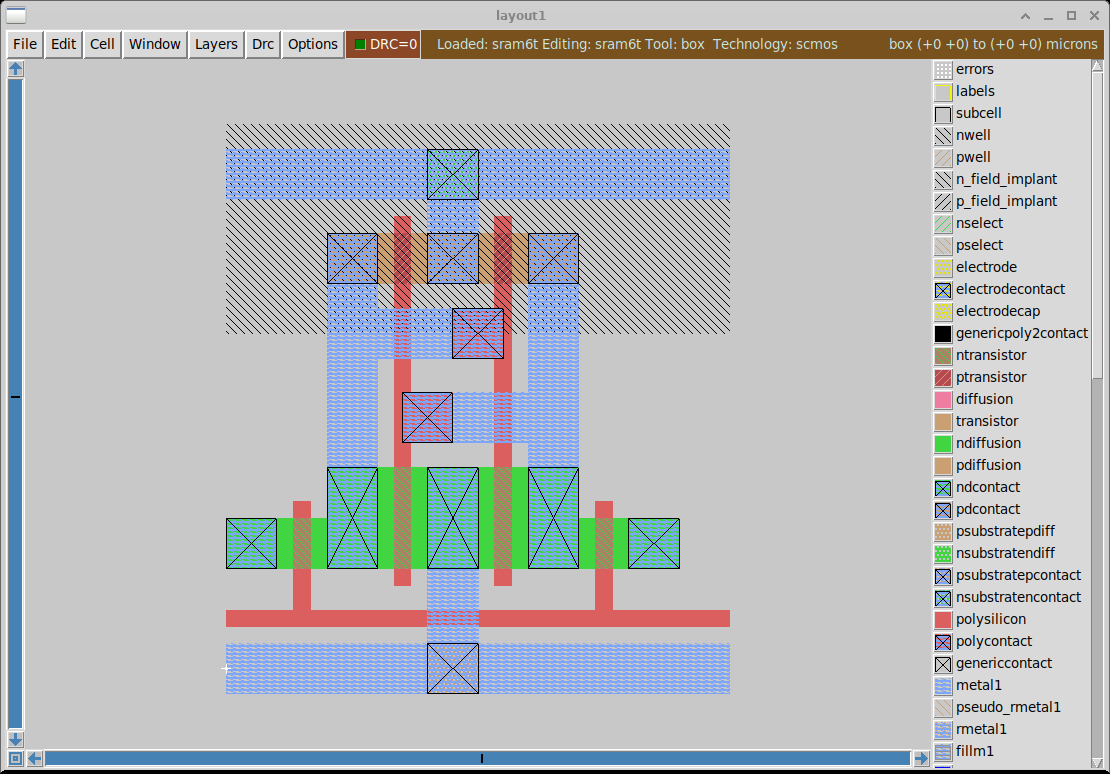
docs/img/25/sram6t_step4_metal1.png
