mseokq23/etri050-6t-sram/sram64x4/docs/img/02/setup_kit_extra.png

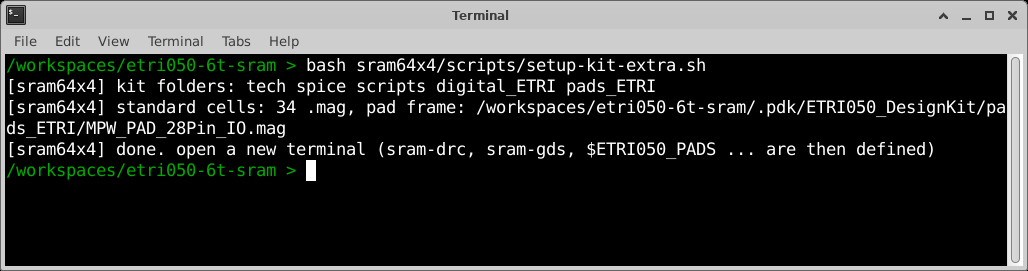
sram64x4/docs/img/02/setup_kit_extra.png
