mseokq23/etri050-6t-sram/sram64x4/docs/img/28/make_top_term.png

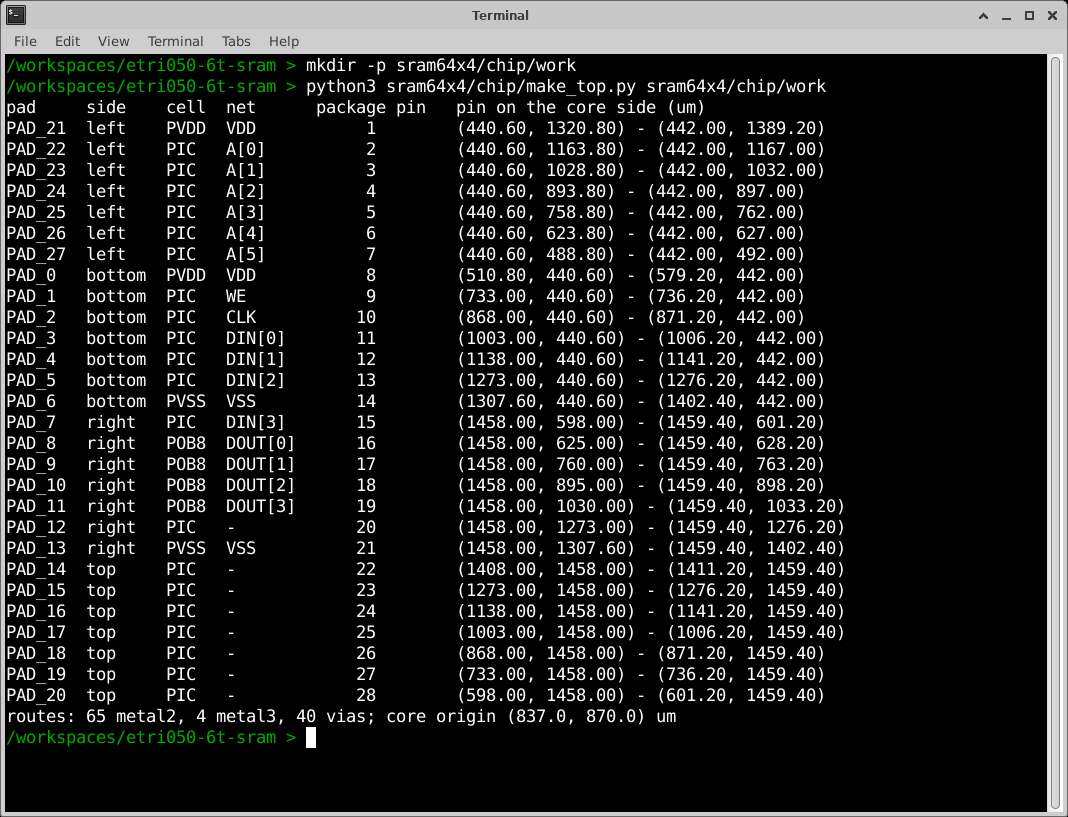
sram64x4/docs/img/28/make_top_term.png
