mseokq23/etri050-6t-sram/(commit log)

2026-11-09 Schematics and ngspice decks: MOS I-V, inverter, 6T cell SNM, write trip, sizing, read/write
    [column.sch, inv.sch, inv_tb.sch, sram6t.sch]
2026-11-09 Magic scripts: exercises, 6T cell in six steps, 4x4 array with pins and power buses
2026-11-10 Add part 2: 64x4 SRAM macro and 28-pin chip flow (sram64x4/)
2026-11-10 Replace vlog2Spice with a small converter (vlog2Spice output depended on the environment)
    [sram64x4_ctrl.v]
